feshie/ms2/README.md

# ms2
second version of the feshie node with the z1 replaced with a plug-in arm processor (TI CC2538)
