feshie/ms2/Muntjac/Partlist.txt

U1		http://onecall.farnell.com/texas-instruments/cc2538sf53rtqt/rf-zigbee-transceiver-qfn-56/dp/2422917
U2		CC1200: http://onecall.farnell.com/texas-instruments/cc1200rhbt/ic-low-power-rf-transceiver-32vqfn/dp/2345430
		CC1120: http://onecall.farnell.com/texas-instruments/cc1120rhbt/rf-transceiver-vqfn-32/dp/2422922

U3		http://onecall.farnell.com/texas-instruments/tpd2e001drlr/esd-protection-array-2ch-sot-5/dp/2335444
U4		http://onecall.farnell.com/silicon-labs/cp2103-gm/usb-uart-bridge-smd-qfn-28-2103/dp/1291538
U5		http://onecall.farnell.com/nxp/bss138ps/mosfet-nn-ch-60v-0-32a-sot363/dp/1972664
U6		http://onecall.farnell.com/nxp/bss138ps/mosfet-nn-ch-60v-0-32a-sot363/dp/1972664
U7		http://onecall.farnell.com/nxp/bss138ps/mosfet-nn-ch-60v-0-32a-sot363/dp/1972664
U8		http://onecall.farnell.com/micron/m25p16-vmn6p/memory-flash-serial-16mbit-8nsoic/dp/1734973
U9		http://onecall.farnell.com/diodes-inc/dmg6602svt/mosfet-np-ch-30v-3-4-atsot23/dp/2061522
U10		http://onecall.farnell.com/diodes-inc/dmg6602svt/mosfet-np-ch-30v-3-4-atsot23/dp/2061522
U11		http://onecall.farnell.com/texas-instruments/sn74avc4t774pw/logic-74avc-transceiver-tssop16/dp/1630205
U12		http://onecall.farnell.com/texas-instruments/tmp102aidrlt/ic-temperature-sensor/dp/1652477

D1		http://onecall.farnell.com/nxp/bat754s/diode-schottky-dual/dp/SC11302

L2		http://onecall.farnell.com/murata/blm18pg600sn1d/ferrite-bead-0-1ohm-500ma-0603/dp/1515746
L3		http://onecall.farnell.com/murata/blm18pg600sn1d/ferrite-bead-0-1ohm-500ma-0603/dp/1515746

X1		CC1200:	http://onecall.farnell.com/epson/q22fa1280010112/crystal-40mhz-10pf-2mm-x-1-6mm/dp/2506959
		CC1120:	http://onecall.farnell.com/epson/q22fa1280011912/crystal-32mhz-10pf-2mm-x-1-6mm/dp/2506957

X2		http://onecall.farnell.com/abracon/abm8g-32-000mhz-b4y-t/crystal-32mhz-10pf-3-2-x-2-5mm/dp/2467852
X3		http://onecall.farnell.com/abracon/abs07-32-768khz-t/crystal-32-768khz-12-5pf-smd/dp/2101347

F1		http://onecall.farnell.com/johanson-technology/0900pc15j0013e/balun-imp-matched-868-928mhz-chip/dp/2341894
F2		http://onecall.farnell.com/johanson-technology/2450bm15a0015e/balun-imp-matched-2-4-2-5ghz-50ohm/dp/2341895		

H4		http://onecall.farnell.com/samtec/fts-105-01-l-d/header-1-27mm-thru-hole-10way/dp/1667728

SD1		http://onecall.farnell.com/molex/503182-1853/connector-micro-sd-push-push-1/dp/2334075

ANT		http://onecall.farnell.com/hirose-hrs/u-fl-r-smt-1-10/rf-coaxial-u-fl-straight-jack/dp/1688077

RST		http://onecall.farnell.com/c-k-components/kmr241g-lfs/switch-smd-4n-0-05a-32vdc-spst/dp/1437637
USR		http://onecall.farnell.com/c-k-components/kmr241g-lfs/switch-smd-4n-0-05a-32vdc-spst/dp/1437637

LED		http://onecall.farnell.com/cree/clv1a-fkb-cj1m1f1bb7r4s3/led-red-grn-blu-550-850-320-mcd/dp/1855553
