feshie/ms2/Muntjac/MS2-BOM-Vals.xlsx

Main Section |  |  | 53
Qty/Brd | Tot | Value | Package | Parts
1 | 3 | USB | USB | J1
2 | 6 | Switch | C&K-KMR-5MM | RST, USR
1 | 3 | UFL | UFL | ANT
1 | 3 | BALUN-2.4G | 2450BM15A0015 | F2
1 | 3 | Tri-colour LED | PLCC-4_3.2X2.8 | LED
1 | 3 | LED Red | 0603 | LED1
1 | 3 | LED Yellow | 0603 | LED2
3 | 9 | 220 | 0603 | R20, R21, R22
2 | 6 | 1K5 | 0603 | R30, R31
3 | 9 | 4.7K | 0603 | R23, R24, R25
3 | 9 | 10k | 0603 | R9, R28, R29
1 | 3 | 56k | 0603 | R8
2 | 6 | 100K | 0603 | R18, R19
4 | 12 | 47p | 0603 | C7, C8, C12, C13
6 | 18 | 100nF | 0603 | C4, C16, C17, C18, C19, C23
7 | 21 | 1uF | 0603 | C2, C3, C9, C10 C14, C15, C22
1 | 3 | 4.7uF | 0603 | C1
1 | 3 | 32.768K | XTAL-3.2X1.5 | X3
1 | 3 | 32MHz | XTAL-3.2X2.5 | X2
3 | 9 | BEAD | 0603 | L2, L3, L5
1 | 3 | BAT54S | SOT23 | D1
1 | 3 | CC2538 | QFN 56 | U1
1 | 3 | TPD2E001IDRLRQ1 | SOT50 | U3
1 | 3 | CP2103 | QFN | U4
2 | 6 | BSS138PS | SOT65 | U5, U6
1 | 3 | M25P16VMN6P | SOIC8 | U8
1 | 3 | TMP102AIDRLT | SOT50 | U12
Through-hole |  |  | 3
Qty/Brd | Tot | Value | Package | Parts
2 | 6 | 2x8 Socket |  | Z1
1 | 3 | 2x11 Socket |  | Z1
Radio Parts |  |  | 33
Qty/Brd | Tot | Value | Package | Parts
1 | 3 | 0900PC15J0013 | Balun/Filter | F1
11 | 33 | 47nF | 0402 | C11, C51, C121, C131, C151, C221, C251, C261, C271, C281, C291
2 | 6 | 15pF | 0402 | C301, C311
1 | 3 | 100pF | 0402 | C172
1 | 3 | 10nH | 0402 | L171
1 | 3 | 220nF | 0402 | C61
1 | 3 | 1.8nF | 0402 | C231
2 | 6 | 10nF | 0402 | C171, C211
1 | 3 | 10R | 0402 | R171
1 | 3 | 33pF | 0402 | C173
1 | 3 | 56K | 0402 | R141
1 | 3 | Crystal | FA-128 | X1 (32MHz for CC1120, 40MHz for CC1200)
1 | 3 | CC1120 | QFN 32 | U2
2 | 6 | BEAD | 0603 | L1, L4
2 | 6 | 100nF | 0603 | C5, C6
2 | 6 | 100K | 0603 | R11, R13
1 | 3 | DMG6602SVT | TSOT26 | U9
1 | 3 | SMA | SMA | ANT_868
SD Card Parts |  |  | 8
Qty/Brd | Tot | Value | Package | Parts
1 | 3 | 1uF | 0603 | C20
1 | 3 | 22uF | 0603 | C21
1 | 3 | MICRO_SD | uSD | SD1
1 | 3 | SN74AVC4T774PW | SOP65 | U11
3 | 9 | 100K | 0603 | R10, R14, R15
1 | 3 | DMG6602SVT | TSOT26 | U10
