feshie/ms2/ms2/MS2-BOM-Vals.xlsx

Qty | Value | Device | Package | Parts | Description | MANUFACTURER | MPN | OC_ONECALL
2 | 10pF | C-EUC0805 | C0805 | C4, C14 | CAPACITOR, European symbol | Multicomp | MC0805N100J500CT | 2320834
2 | 100nF | C-EUC0805 | C0805 | C9, C11, C17, C19, C20, C21, C22, C23 | CAPACITOR, European symbol | Multicomp | MC0805B104K500CT | 1759265
2 | 0.22uF | C-EUC0805 | C0805 | C2, C13 | CAPACITOR, European symbol | Multicomp | MC0805F224Z500CT | 1759269
3 | 1uF | C-EUC0805 | C0805 | C8, C10, C16 | CAPACITOR, European symbol | Multicomp | MC0805X105K250CT | 2320832
1 | 10 | R-EU_R0805 | R0805 | R16 | RESISTOR, European symbol | Multicomp | MCWR08X10R0FTL | 2447556
8 | 68 | R-EU_R0805 | R0805 | R14, R15, R18, R19, R23, R24, R26, R31 | RESISTOR, European symbol | Multicomp | MCHP05W4F680JT5E | 1576443
14 | 100K | R-EU_R0805 | R0805 | R1, R5, R6, R7, R10, R11, R12, R13, R28, R29, R33, R35, R38, R39 | RESISTOR, European symbol | Multicomp | MCHP05W4F1003T5E | 1576493
6 | 1M | R-EU_R0805 | R0805 | R2, R4, R20, R34, R36, R37 | RESISTOR, European symbol | Multicomp | MCHP05W4F1004T5E | 1576507
4 | 2.2uF | C-EUC0805 | C0805 | C1, C6, C12, C18 | CAPACITOR, European symbol | Murata | GRM21BR61H225KA73L | 1845751RL
1 | 68uF | CPOL-EUE | PANASONIC_E | C15 | POLARIZED CAPACITOR, European symbol | Panasonic | EEEFC1E680P | 9693530
3 | 100uF | CPOL-EUE | PANASONIC_E | C5, C7, C24 | POLARIZED CAPACITOR, European symbol | Panasonic | EEEFK1E101P | 9695770
4 | 120 | R-EU_R0805 | R0805 | R22, R27, R30, R32 | RESISTOR, European symbol | Multicomp | MCHP05W4F1200T5E | 1576447RL
2 | 680 | R-EU_R0805 | R0805 | R17, R25 | RESISTOR, European symbol | Multicomp | MCHP05W4F6800T5E | 1576456
1 | 1K 0.1% | R-EU_R0805 | R0805 | R8 | RESISTOR, European symbol | Panasonic | ERA6AEB102V | 1577659
1 | 200R 0.1% | R-EU_R0805 | R0805 | R9 | RESISTOR, European symbol | Panasonic | ERA6AEB201V | 1670217
1 | 332K | R-EU_R0805 | R0805 | R21 | RESISTOR, European symbol | Welwyn | PCF0805R-332KBT1 | 1160284
1 | 562K | R-EU_R0805 | R0805 | R3 | RESISTOR, European symbol | Welwyn | PCF0805R-562KBT1 | 1160297
2 | BEAD | BEAD | 0805 | L3, L4 | INDUCTOR, European symbol | Murata | BLM21PG121SN1D | 2443252RL
1 | 47uH | SRU1048 | 1048 | L1 | CHOKE, POWER, SHIELDED, 47UH, 10mm x 10mm x 4.8mm | Bourns | SRU1048-470Y | 1362022
1 | 68uH | DR127 | DR127 | L5 | INDUCTOR, 68UH, POWER, SHIELDED, SMD | Bourns | SRR1260-680M | 2212503
1 | B130LB-13-F | DIODE-SMB | SMB | D1 | DIODE, REC, SCHOTTKY, 30V, 1A, SMB | Diodes Inc | B130LB-13-F | 1858651
5 | DMG6602SVT | DMG6602SVT | TSOT26 | Q1, Q2, Q3, Q4, Q5 | MOSFET, NP CH, , 30V, 3.4, ATSOT23 | Diodes Inc | DMG6602SVT | 2061522
1 | DS3231SN | DS3231SN | SOIC-16 | U3 | Extremely Accurate I2C-Integrated RTC/TCXO/Crystal | Maxim | DS3231SN | 1593292
3 | ISL3179EIBZ | ISL3179EIBZ | SOIC-8 | U4, U5, U6 | TRANCEIVER | Intersil | ISL3179EIBZ | 1439860
2 | LT1934ES6TRMPBF | LT1934ES6TRMPBF | TSOT-23-6 | U1, U2 | Micropower Step-Down Switching Regulators | Linear Technology | LT1934ES6#TRMPBF | 1663810
2 | MBR0530T1G | MBR0530T1G | SOD123 | D11, D12 | SCHOTTKY BARRIER RECTIFIER | ON Semiconductor | MBR0530T1G | 1431036
4 | MBR0540 | MBR0540T3G | SOD123 | D2, D3, D4, D5 | SCHOTTKY BARRIER RECTIFIER | ON Semiconductor | MBR0540T3G | 2101839
13 | MCF0805 | MCF0805 | 0805 | F1, F2, F3, F4, F5, F6, F7, F8, F9, F10, F11, F15, F16 |  | Bourns | MF-PSMF020X-2 | 1294874RL
6 | LED Green | LEDCHIP-LED0805 | CHIP-LED0805 | LED5, LED8, LED9, LED10, LED11, LED12 | LED | KINGBRIGHT | KPT-2012SGC | 2099239
1 | LED Red | LEDCHIP-LED0805 | CHIP-LED0805 | LED4 | LED | KINGBRIGHT | KPT-2012SURCK | 2099241
1 | LED Orange | LEDCHIP-LED0805 | CHIP-LED0805 | LED2 | LED | KINGBRIGHT | KPT-2012SECK | 2099237
2 | LED Yellow | LEDCHIP-LED0805 | CHIP-LED0805 | LED1, LED6 | LED | KINGBRIGHT | KPT-2012YC | 2099243
2 | LED Blue | LEDCHIP-LED0805 | CHIP-LED0805 | LED3, LED7 | LED | KINGBRIGHT | KPT-2012QBC-D | 2217980
1 | SN74HC21PW | SN74HC21PW | SOP65P640X120-14N | U11 | Triple 3 Input positive NAND gate | Texas Instruments | SN74HC21PW | 1741215
1 | TPD2E001IDRLRQ1 | TPD2E001IDRLRQ1 | SOT50P160X60-5N | U7 | LOW-CAPACITANCE 2-CHANNEL ±15-kV ESD-PROTECTION ARRAY | Texas Instruments | TPD2E001IDRLRQ1 | 2496524
1 | TPS79333DBVR | TPS79333DBVR | SOT-23 | U8 | LOW-DROPOUT LINEAR REGULATORS | Texas Instruments | TPS79333DBVR | 1470478
1 | REG113NA | REG113NA | SOT-23 | U9 | LOW-DROPOUT LINEAR REGULATORS | Texas Instruments | REG113NA | 2342575
1 | TXS0108E | TXS0108E | TSSOP20 | U10 | Texas Instruments TXS0108E | Texas Instruments | TXS0108E | 1702548
1 | BUTTON_CELL_NEW | BUTTON_CELL_NEW | CR2016 | U$3 | CR2032 cell holder | Keystone | 3002 | 1650693
2 | CC1120-HEADER-SMT | CC1120-HEADER-SMT | CC1120-HEADERS-SMT | U$8 | 2x Harwin M50 | HARWIN | M50-3601042 | CN14037
