feshie/ms2/ms2/Powersupply.asc

C1: cap; 0.22µ; V=10 Irms=1.21 Rser=0.0269337 Lser=0 mfg="KEMET" pn="C0603C224K8RAC" type="X7R"
C2: polcap; 100µ; V=2 Irms=3 Rser=0.011 Lser=0 mfg="Rubycon" pn="2SXB100M" type="Al electrolytic"
C3: cap; 2.2µ
C4: cap; 10p; V=50 Irms=20.8m Rser=5.448 Lser=0
C6: polcap; 100µ; V=2 Irms=3 Rser=0.011 Lser=0 mfg="Rubycon" pn="2SXB100M" type="Al electrolytic"
D1: schottky; MBRS130L
D2: schottky; BAT54
D3: schottky; MBR0530L
L1: ind; 47µ; Ipk=0.2 Rser=2.145 Rpar=22000 Cpar=2p mfg="Wurth Elektronik" pn="744029470 WE-TPC 2813"
R1: RES; 1Meg; tol=1 pwr=0.1
R2: res; 569K
R3: RES; 1000K
R4: RES; 100K
R5: res; 220; tol=1 pwr=1
R6: res; 1Meg; tol=1 pwr=0.1
U1: LT1934
U3: LTC1844-3.3
V1: VOLTAGE; 12
Named nets: 0, OUT, IN, VIN, 3V4
.tran 50 startup
.options gmin=1e-10
