feshie/ms2/ms2/ms2.brd

## EAGLE design ms2/ms2.brd (2016-06-14)

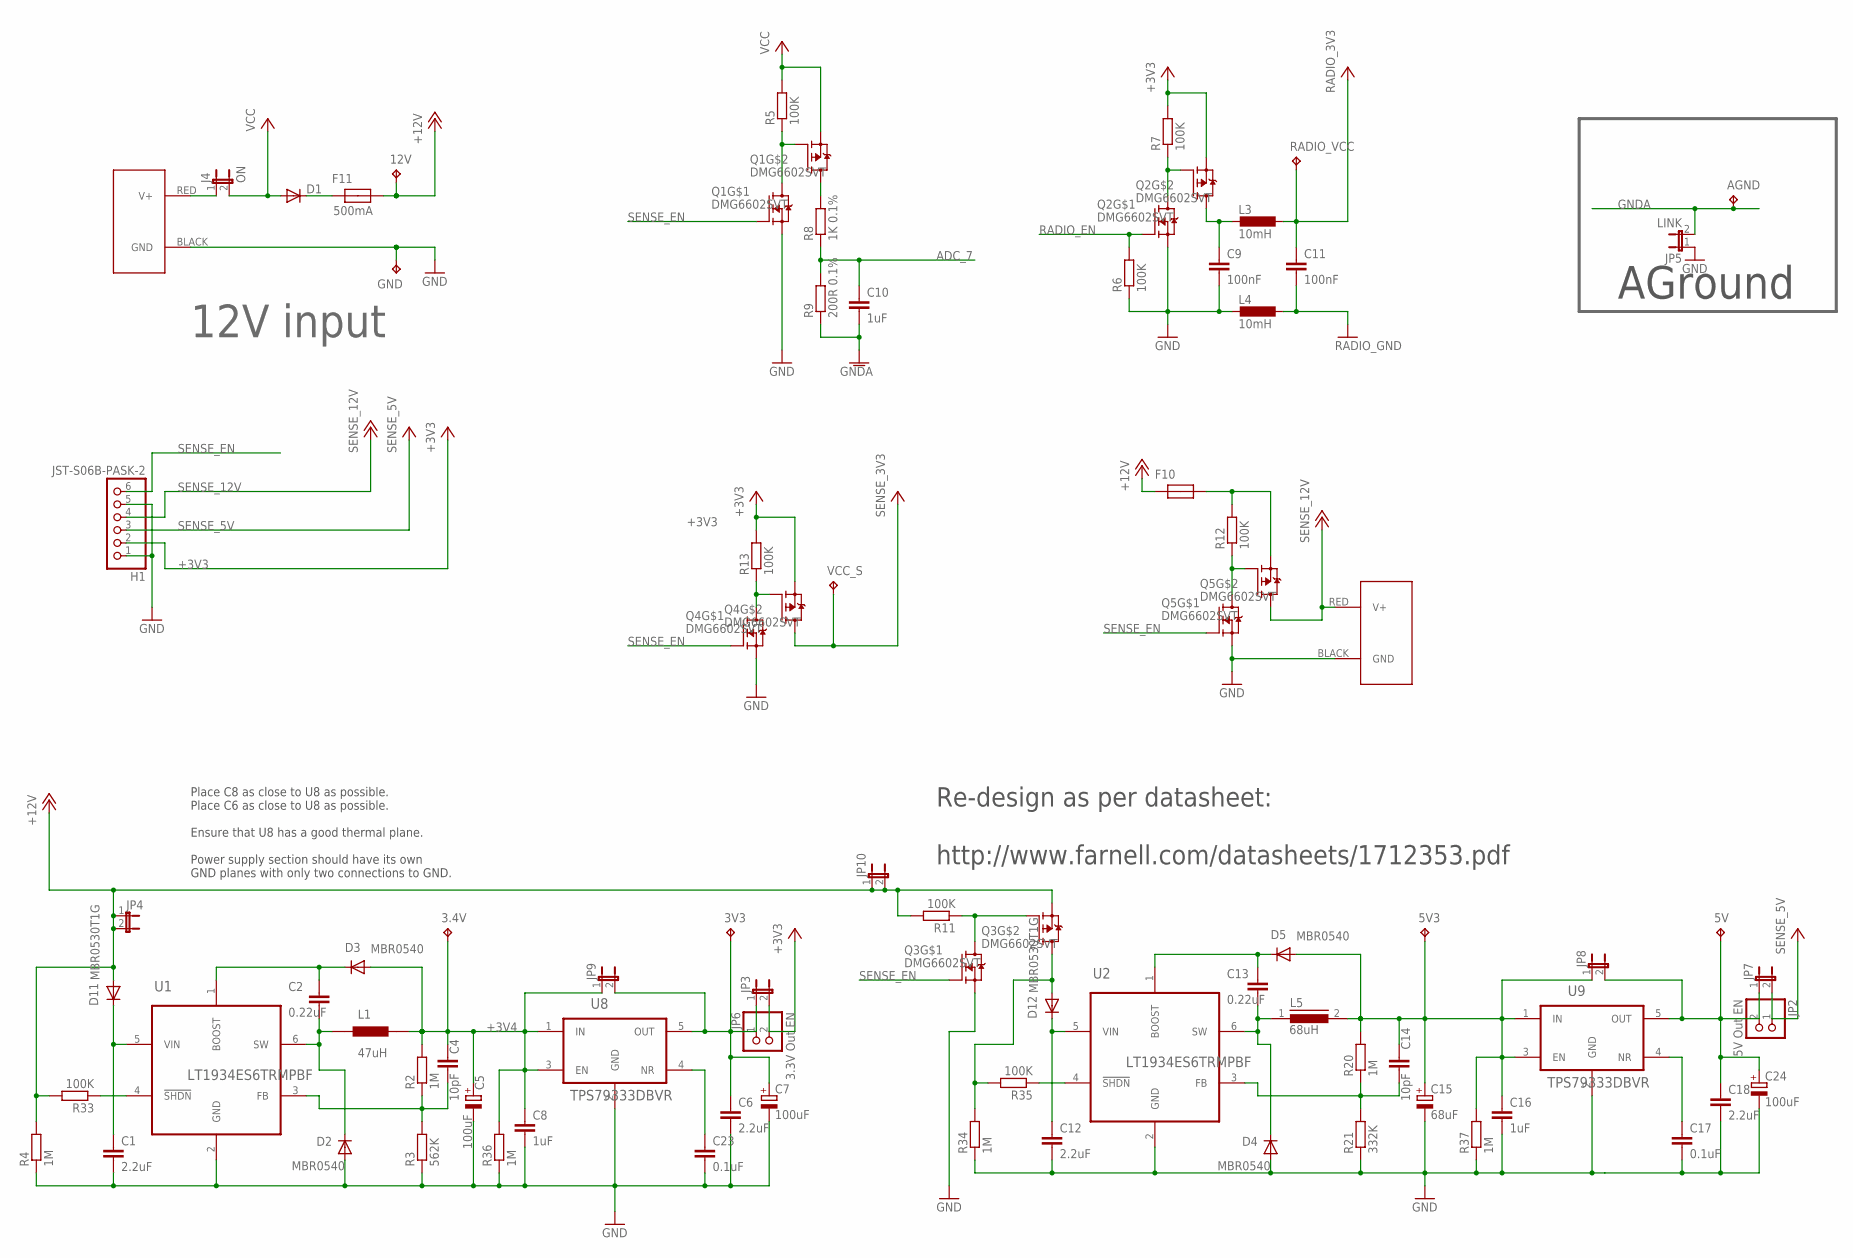
[picture p1: schematic ms2.sch, sheet 1, Power]

Parts:
3.4V, 3V3, 12V: TPB2,54; B2,54
5V, 5V3: 5V B; B2,54
12V_OUT: POWERPOLE_POWER45A; POWERPOLE_PAIR_45A
AGND: TPB2,54; B2,54
C1, C6, C12, C18: 2.2uF; C0805
C2, C13: 0.22uF; C0805
C4, C14: 10pF; C0805
C5, C7, C24: 100uF; PANASONIC_E
C8, C10, C16: 1uF; C0805
C9, C11: 100nF; C0805
C15: 68uF; PANASONIC_E
C17, C23: 0.1uF; C0805
D1: DIODE-SMB; SMB
D2, D3, D4, D5: MBR0540; SOD123
D11, D12: MBR0530T1G; SOD123
F10, F11: MCF0805; 0805
GND: 5V B; B2,54
H1: JST-S06B-PASK-2; JST-PA-6-SE
J1: POWERPOLE_POWER45A; POWERPOLE_PAIR_45A
J4: ON; 2-MOLEX
JP2: 5V Out EN; 1X02
JP3, JP4, JP7, JP8, JP9, JP10: JUMPER-2SMD-NO; SJ_2S-NO
JP5: LINK; JP1
JP6: 3.3V Out EN; 1X02
L1: 47uH; 1048
L3, L4: 10mH; L3230M
L5: 68uH; DR127
Q1, Q2, Q3, Q4, Q5: DMG6602SVT; TSOT26
R2, R4, R20, R34, R36, R37: 1M; R0805
R3: 562K; R0805
R5, R6, R7, R11, R12, R13, R33, R35: 100K; R0805
R8: 1K 0.1%; R0805
R9: 200R 0.1%; R0805
R21: 332K; R0805
RADIO_VCC: TPB2,54; B2,54
U1, U2: LT1934ES6TRMPBF; SOT95P280X100-6N
U8, U9: TPS79333DBVR; SOT95P280X145-5N
VCC_S: TPB2,54; B2,54

Connections:
5V3: 5V3.TP, C14.1, C15.+, C16.1, D5.A, JP8.1, L5.2, R20.2, R37.2, U9.1 (IN), U9.3 (EN)
+3V3: H1.2, JP3.2, JP6.2, Q2.P$2 (S), Q4.P$2 (S), R7.2, R13.2; also elsewhere on the board
+3V4: 3.4V.TP, C4.1, C5.+, C8.1, D3.A, JP9.1, L1.2, R2.2, R36.2, U8.1 (IN), U8.3 (EN)
+12V: 12V.TP, D11.A, F10.1, F11.2, JP4.1, JP4.2, JP10.1, JP10.2, Q3.P$2 (S), R4.2, R11.2, R33.2
ADC_7: C10.1, R8.1, R9.2; also elsewhere on the board
GND: 12V_OUT.BLACK (GND), C1.2, C5.-, C6.2, C7.-, C8.2, C9.2, C12.2, C15.-, C16.2, C17.2, C18.2, C23.2, C24.-, D2.A, D4.A, GND.TP, H1.1, H1.5, J1.BLACK (GND), JP5.1, L4.2, Q1.P$5 (S), Q2.P$5 (S), Q3.P$5 (S), Q4.P$5 (S), Q5.P$5 (S), R3.1, R4.1, R6.1, R21.1, R34.1, R36.1, R37.1, U1.2 (GND), U2.2 (GND), U8.2 (GND), U9.2 (GND); also elsewhere on the board
GNDA: AGND.TP, C10.2, JP5.2, R9.1; also elsewhere on the board
unnamed: J1.RED (V+), J4.1
unnamed: C13.1, D5.C, U2.1 (BOOST)
unnamed: D1.C, F11.1
unnamed: C23.1, U8.4 (NR)
unnamed: Q2.P$3 (G), Q2.P$6 (D), R7.1
unnamed: Q1.P$3 (G), Q1.P$6 (D), R5.1
unnamed: 5V.TP, C18.1, C24.+, JP2.2, JP7.1, JP8.2, U9.5 (OUT)
unnamed: C9.1, L3.2, Q2.P$4 (D)
unnamed: Q3.P$3 (G), Q3.P$6 (D), R11.1
unnamed: Q4.P$3 (G), Q4.P$6 (D), R13.1
unnamed: C12.1, D12.C, U2.5 (VIN)
unnamed: C13.2, D4.C, L5.1, U2.6 (SW)
unnamed: C4.2, R2.1, R3.2, U1.3 (FB)
unnamed: 3V3.TP, C6.1, C7.+, JP3.1, JP6.1, JP9.2, U8.5 (OUT)
unnamed: C14.2, R20.1, R21.2, U2.3 (FB)
unnamed: Q5.P$3 (G), Q5.P$6 (D), R12.1
unnamed: F10.2, Q5.P$2 (S), R12.2
unnamed: C1.1, D11.C, U1.5 (VIN)
unnamed: R33.1, U1.4 (!SHDN)
unnamed: R35.1, U2.4 (!SHDN)
unnamed: D12.A, Q3.P$4 (D), R34.2, R35.2
unnamed: C17.1, U9.4 (NR)
unnamed: C2.2, D2.C, L1.1, U1.6 (SW)
unnamed: C2.1, D3.C, U1.1 (BOOST)
RADIO_3V3: C11.1, L3.1, RADIO_VCC.TP; also elsewhere on the board
RADIO_EN: Q2.P$1 (G), R6.2; also elsewhere on the board
RADIO_GND: C11.2, L4.1; also elsewhere on the board
SENSE_3V3: Q4.P$4 (D), VCC_S.TP; also elsewhere on the board
SENSE_5V: H1.3, JP2.1, JP7.2; also elsewhere on the board
SENSE_12V: 12V_OUT.RED (V+), H1.4, Q5.P$4 (D); also elsewhere on the board
SENSE_EN: H1.6, Q1.P$1 (G), Q3.P$1 (G), Q4.P$1 (G), Q5.P$1 (G); also elsewhere on the board
VCC: D1.A, J4.2, Q1.P$2 (S), R5.2; also elsewhere on the board
VCC_HP2_SW1: Q1.P$4 (D), R8.2

Notes on the sheet:
12V input
AGround
Re-design as per datasheet: http://www.farnell.com/datasheets/1712353.pdf
Place C8 as close to U8 as possible. Place C6 as close to U8 as possible. Ensure that U8 has a good thermal plane. Power supply section should have its own GND planes with only two connections to GND.
500mA

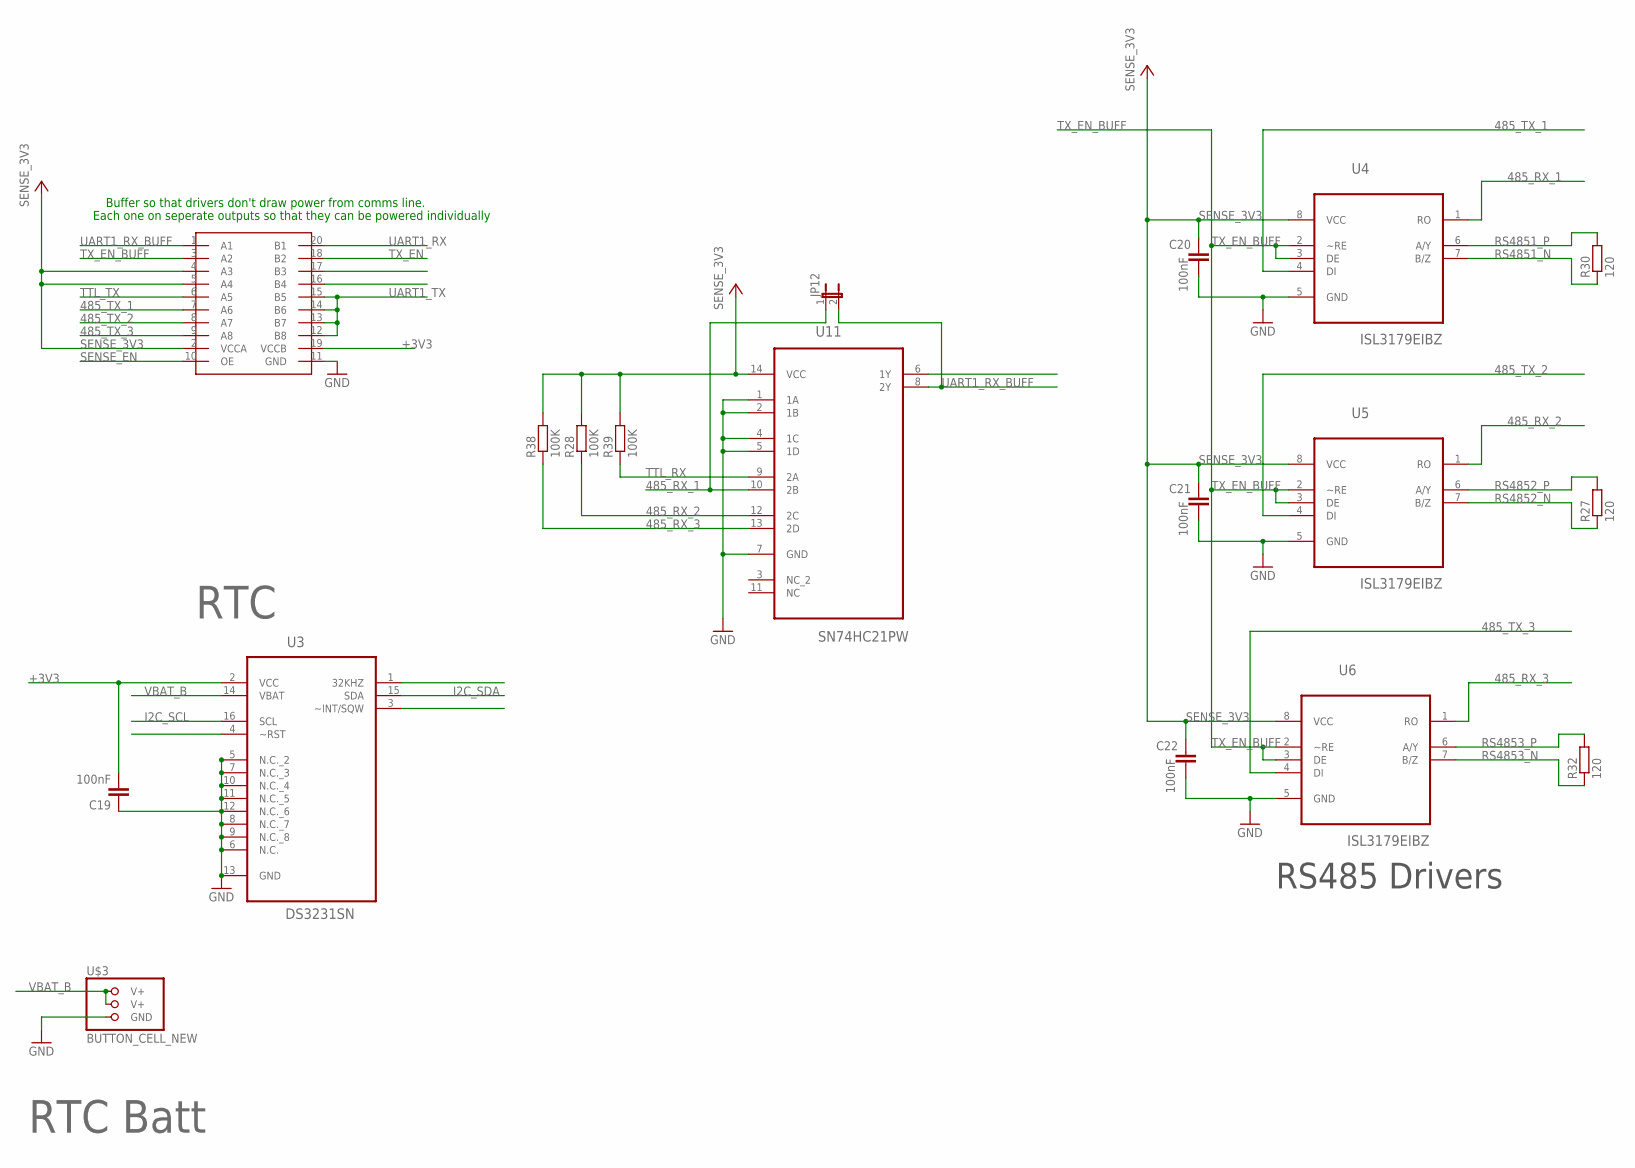
[picture p2: schematic ms2.sch, sheet 2, ICs]

Parts:
C19, C20, C21, C22: 100nF; C0805
JP12: JUMPER-2SMD-NO; SJ_2S-NO
R27, R30, R32: 120; R0805
R28, R38, R39: 100K; R0805
U3: DS3231SN; SOIC127P1032X265-16N
U4, U5, U6: ISL3179EIBZ; SOIC127P600X175-8N
U10: TXS0108E; TSSOP20
U11: SN74HC21PW; SOP65P640X120-14N
U$3: BUTTON_CELL_NEW; CR2016

Connections:
485_RX_1: JP12.1, U4.1 (RO), U11.10 (2B)
485_RX_2: R28.1, U5.1 (RO), U11.12 (2C)
485_RX_3: R38.1, U6.1 (RO), U11.13 (2D)
485_TX_1: U4.4 (DI), U10.7 (A6)
485_TX_2: U5.4 (DI), U10.8 (A7)
485_TX_3: U6.4 (DI), U10.9 (A8)
+3V3: C19.2, U3.2 (VCC), U10.19 (VCCB); also elsewhere on the board
GND: C19.1, C20.2, C21.2, C22.2, U3.5 (N.C._2), U3.6 (N.C.), U3.7 (N.C._3), U3.8 (N.C._7), U3.9 (N.C._8), U3.10 (N.C._4), U3.11 (N.C._5), U3.12 (N.C._6), U3.13 (GND), U4.5 (GND), U5.5 (GND), U6.5 (GND), U10.11 (GND), U11.1 (1A), U11.2 (1B), U11.4 (1C), U11.5 (1D), U11.7 (GND), U$3.GND; also elsewhere on the board
I2C_SCL: U3.16 (SCL); also elsewhere on the board
I2C_SDA: U3.15 (SDA); also elsewhere on the board
RS4851_N: R30.1, U4.7 (B/Z); also elsewhere on the board
RS4851_P: R30.2, U4.6 (A/Y); also elsewhere on the board
RS4852_N: R27.1, U5.7 (B/Z); also elsewhere on the board
RS4852_P: R27.2, U5.6 (A/Y); also elsewhere on the board
RS4853_N: R32.1, U6.7 (B/Z); also elsewhere on the board
RS4853_P: R32.2, U6.6 (A/Y); also elsewhere on the board
SENSE_3V3: C20.1, C21.1, C22.1, R28.2, R38.2, R39.2, U4.8 (VCC), U5.8 (VCC), U6.8 (VCC), U10.2 (VCCA), U10.4 (A3), U10.5 (A4), U11.14 (VCC); also elsewhere on the board
SENSE_EN: U10.10 (OE); also elsewhere on the board
TTL_RX: R39.1, U11.9 (2A); also elsewhere on the board
TTL_TX: U10.6 (A5); also elsewhere on the board
TX_EN: U10.18 (B2); also elsewhere on the board
TX_EN_BUFF: U4.2 (~RE), U4.3 (DE), U5.2 (~RE), U5.3 (DE), U6.2 (~RE), U6.3 (DE), U10.3 (A2)
UART1_RX: U10.20 (B1); also elsewhere on the board
UART1_RX_BUFF: JP12.2, U10.1 (A1), U11.8 (2Y)
UART1_TX: U10.12 (B8), U10.13 (B7), U10.14 (B6), U10.15 (B5); also elsewhere on the board
VBAT_B: U3.14 (VBAT), U$3.V+@1 (V+), U$3.V+@2 (V+)

Notes on the sheet:
RTC
RS485 Drivers
Buffer so that drivers don't draw power from comms line.
Each one on seperate outputs so that they can be powered individually
RTC Batt

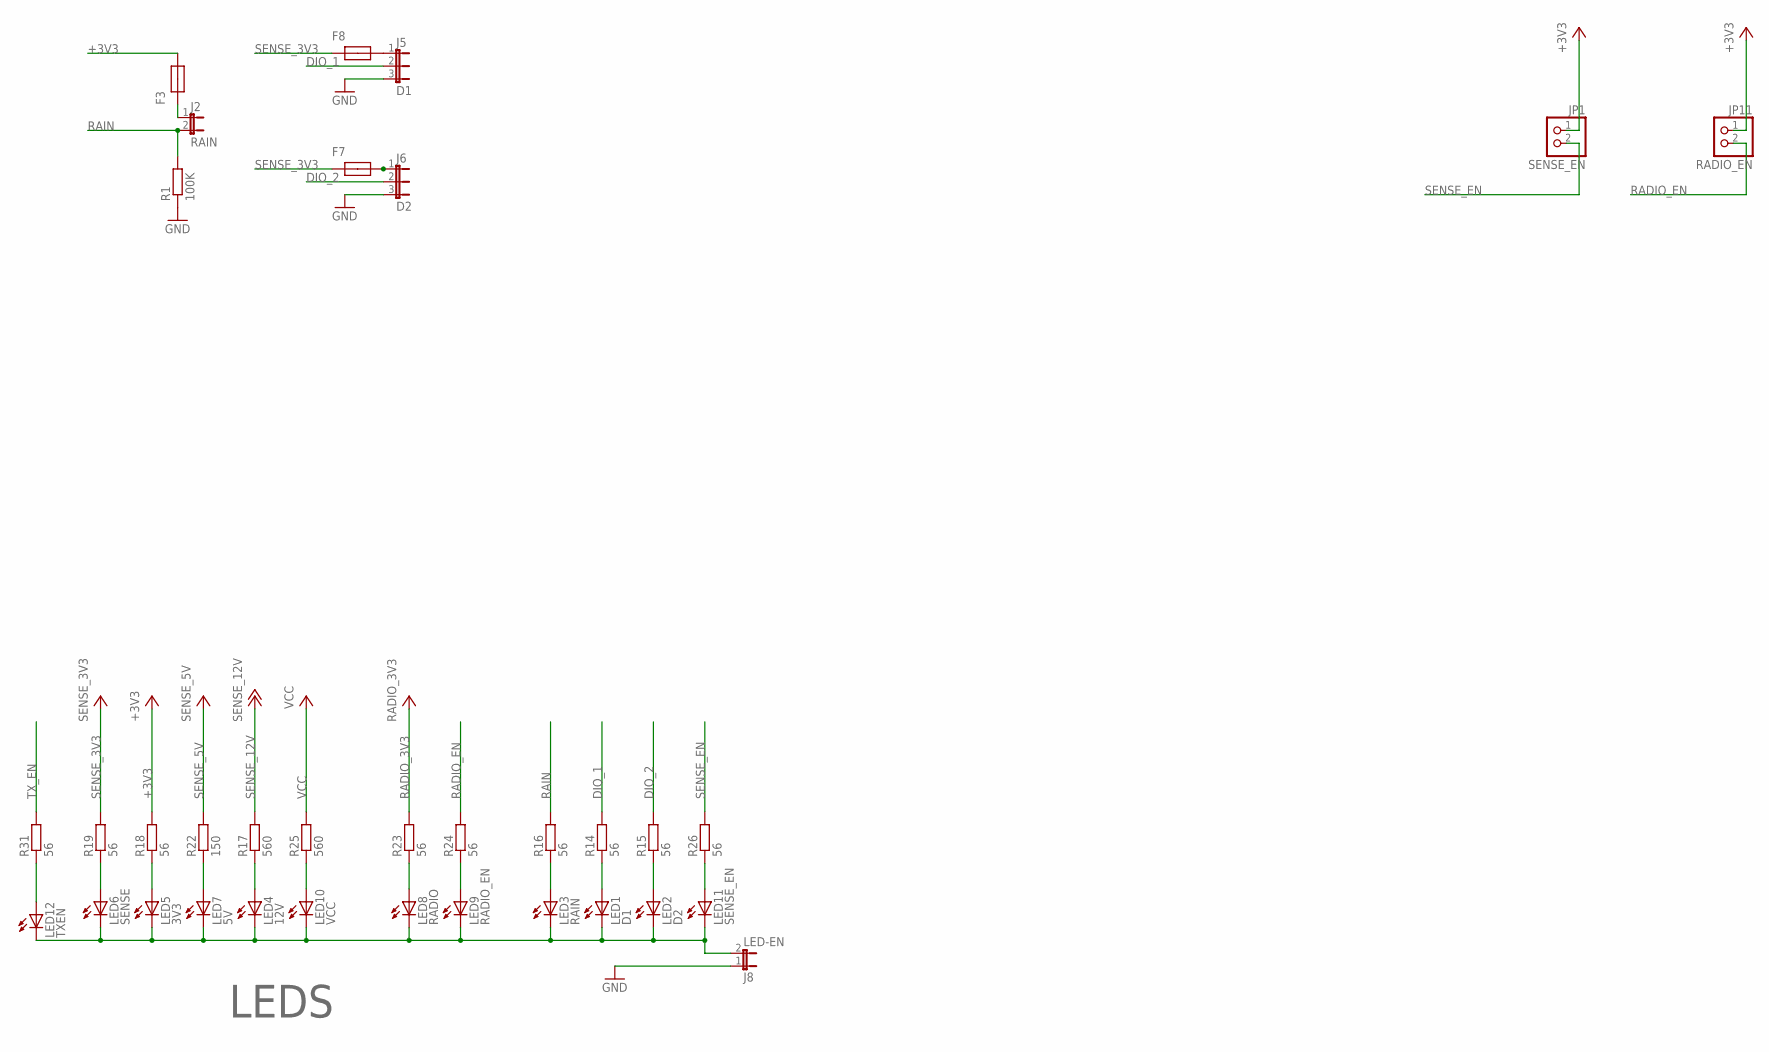
[picture p3: schematic ms2.sch, sheet 3, HMI]

Parts:
F3, F7, F8: MCF0805; 0805
J2: RAIN; 2-MOLEX
J5: D1; 3-MOLEX
J6: D2; 3-MOLEX
J8: LED-EN; 2-MOLEX
JP1: SENSE_EN; 1X02
JP11: RADIO_EN; 1X02
LED1: D1; CHIP-LED0805
LED2: D2; CHIP-LED0805
LED3: RAIN; CHIP-LED0805
LED4: 12V; CHIP-LED0805
LED5: 3V3; CHIP-LED0805
LED6: SENSE; CHIP-LED0805
LED7: 5V; CHIP-LED0805
LED8: RADIO; CHIP-LED0805
LED9: RADIO_EN; CHIP-LED0805
LED10: VCC; CHIP-LED0805
LED11: SENSE_EN; CHIP-LED0805
LED12: TXEN; CHIP-LED0805
R1: 100K; R0805
R14, R15, R16, R18, R19, R23, R24, R26, R31: 56; R0805
R17, R25: 560; R0805
R22: 150; R0805

Connections:
+3V3: F3.2, JP1.1, JP11.1, R18.2; also elsewhere on the board
DIO_1: J5.2, R14.2; also elsewhere on the board
DIO_2: J6.2, R15.2; also elsewhere on the board
GND: J5.3, J6.3, J8.1, R1.1; also elsewhere on the board
LGND: J8.2, LED1.C, LED2.C, LED3.C, LED4.C, LED5.C, LED6.C, LED7.C, LED8.C, LED9.C, LED10.C, LED11.C, LED12.C
unnamed: LED4.A, R17.1
unnamed: LED9.A, R24.1
unnamed: LED3.A, R16.1
unnamed: LED2.A, R15.1
unnamed: F7.2, J6.1
unnamed: F8.2, J5.1
unnamed: LED1.A, R14.1
unnamed: F3.1, J2.1
unnamed: LED12.A, R31.1
unnamed: LED11.A, R26.1
unnamed: LED10.A, R25.1
unnamed: LED8.A, R23.1
unnamed: LED7.A, R22.1
unnamed: LED6.A, R19.1
unnamed: LED5.A, R18.1
RADIO_3V3: R23.2; also elsewhere on the board
RADIO_EN: JP11.2, R24.2; also elsewhere on the board
RAIN: J2.2, R1.2, R16.2; also elsewhere on the board
SENSE_3V3: F7.1, F8.1, R19.2; also elsewhere on the board
SENSE_5V: R22.2; also elsewhere on the board
SENSE_12V: R17.2; also elsewhere on the board
SENSE_EN: JP1.2, R26.2; also elsewhere on the board
TX_EN: R31.2; also elsewhere on the board
VCC: R25.2; also elsewhere on the board

Notes on the sheet:
LEDS

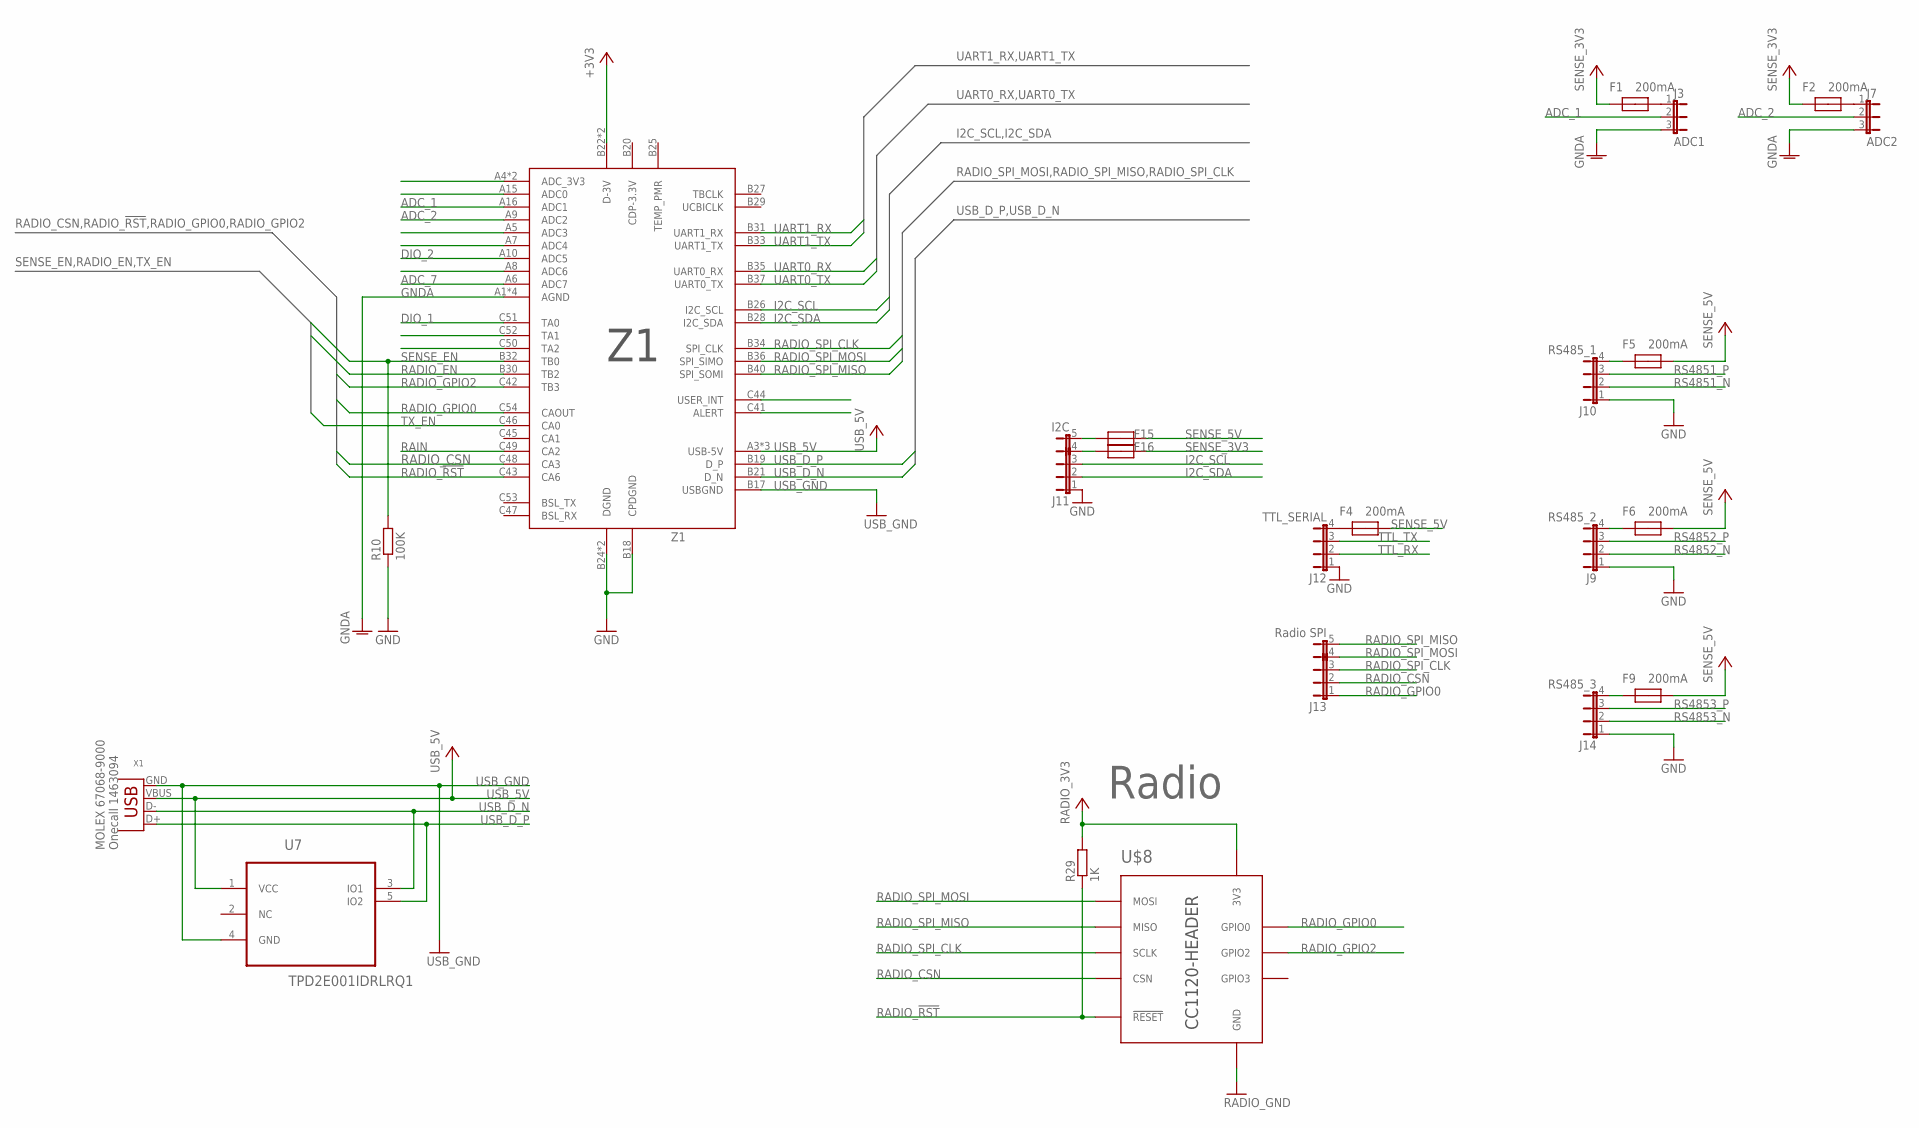
[picture p4: schematic ms2.sch, sheet 4, Headers]

Parts:
F1, F2, F4, F5, F6, F9, F15, F16: MCF0805; 0805
J3: ADC1; 3-MOLEX
J7: ADC2; 3-MOLEX
J9: RS485_2; 4-MOLEX
J10: RS485_1; 4-MOLEX
J11: I2C; 5-MOLEX
J12: TTL_SERIAL; 4-MOLEX
J13: Radio SPI; 5-MOLEX
J14: RS485_3; 4-MOLEX
R10: 100K; R0805
R29: 1K; R0805
U7: TPD2E001IDRLRQ1; SOT50P160X60-5N
U$8: CC1120-HEADER-SMT; CC1120-HEADERS-SMT
X1: 67068-9000; USB-B-H
Z1: Z1

Connections:
+3V3: Z1.B22 (D-3V), Z1.C40 (D-3V); also elsewhere on the board
ADC_1: J3.2, Z1.A16 (ADC1)
ADC_2: J7.2, Z1.A9 (ADC2)
ADC_7: Z1.A6 (ADC7); also elsewhere on the board
DIO_1: Z1.C51 (TA0); also elsewhere on the board
DIO_2: Z1.A10 (ADC5); also elsewhere on the board
GND: J9.1, J10.1, J11.1, J12.1, J14.1, R10.1, Z1.B18 (CPDGND), Z1.B24 (DGND), Z1.C39 (DGND); also elsewhere on the board
GNDA: J3.3, J7.3, Z1.A1 (AGND), Z1.A2 (AGND), Z1.A11 (AGND), Z1.A12 (AGND); also elsewhere on the board
I2C_SCL: J11.3, Z1.B26 (I2C_SCL); also elsewhere on the board
I2C_SDA: J11.2, Z1.B28 (I2C_SDA); also elsewhere on the board
unnamed: F5.1, J10.4
unnamed: F6.1, J9.4
unnamed: F4.1, J12.4
unnamed: F9.1, J14.4
unnamed: F1.2, J3.1
unnamed: F2.2, J7.1
unnamed: Z1.A4 (ADC_3V3), Z1.A14 (ADC_3V3)
unnamed: F16.1, J11.4
unnamed: F15.1, J11.5 (6)
RADIO_3V3: R29.2, U$8.3V3-1 (3V3), U$8.3V3-2 (3V3); also elsewhere on the board
RADIO_!RST: R29.1, U$8.RESET (!RESET), Z1.C43 (CA6)
RADIO_CSN: J13.2, U$8.CSN, Z1.C48 (CA3)
RADIO_EN: Z1.B30 (TB2); also elsewhere on the board
RADIO_GND: U$8.GND, U$8.GND1 (GND), U$8.GND2 (GND); also elsewhere on the board
RADIO_GPIO0: J13.1, U$8.GPIO0, Z1.C54 (CAOUT)
RADIO_GPIO2: U$8.GPIO2, Z1.C42 (TB3)
RADIO_SPI_CLK: J13.3, U$8.SCLK, Z1.B34 (SPI_CLK)
RADIO_SPI_MISO: J13.5 (6), U$8.MISO, Z1.B40 (SPI_SOMI)
RADIO_SPI_MOSI: J13.4, U$8.MOSI, Z1.B36 (SPI_SIMO)
RAIN: Z1.C49 (CA2); also elsewhere on the board
RS4851_N: J10.2; also elsewhere on the board
RS4851_P: J10.3; also elsewhere on the board
RS4852_N: J9.2; also elsewhere on the board
RS4852_P: J9.3; also elsewhere on the board
RS4853_N: J14.2; also elsewhere on the board
RS4853_P: J14.3; also elsewhere on the board
SENSE_3V3: F1.1, F2.1, F16.2; also elsewhere on the board
SENSE_5V: F4.2, F5.2, F6.2, F9.2, F15.2; also elsewhere on the board
SENSE_EN: R10.2, Z1.B32 (TB0); also elsewhere on the board
TTL_RX: J12.2; also elsewhere on the board
TTL_TX: J12.3; also elsewhere on the board
TX_EN: Z1.C46 (CA0); also elsewhere on the board
UART0_RX: Z1.B35 (UART0_RX)
UART0_TX: Z1.B37 (UART0_TX)
UART1_RX: Z1.B31 (UART1_RX); also elsewhere on the board
UART1_TX: Z1.B33 (UART1_TX); also elsewhere on the board
USB_5V: U7.1 (VCC), X1.VBUS, Z1.A3 (USB-5V), Z1.A13 (USB-5V), Z1.B23 (USB-5V)
USB_D_N: U7.3 (IO1), X1.D-, Z1.B21 (D_N)
USB_D_P: U7.5 (IO2), X1.D+, Z1.B19 (D_P)
USB_GND: U7.4 (GND), X1.GND, Z1.B17 (USBGND)

Notes on the sheet:
Radio
200mA
MOLEX 67068-9000 Onecall 1463094

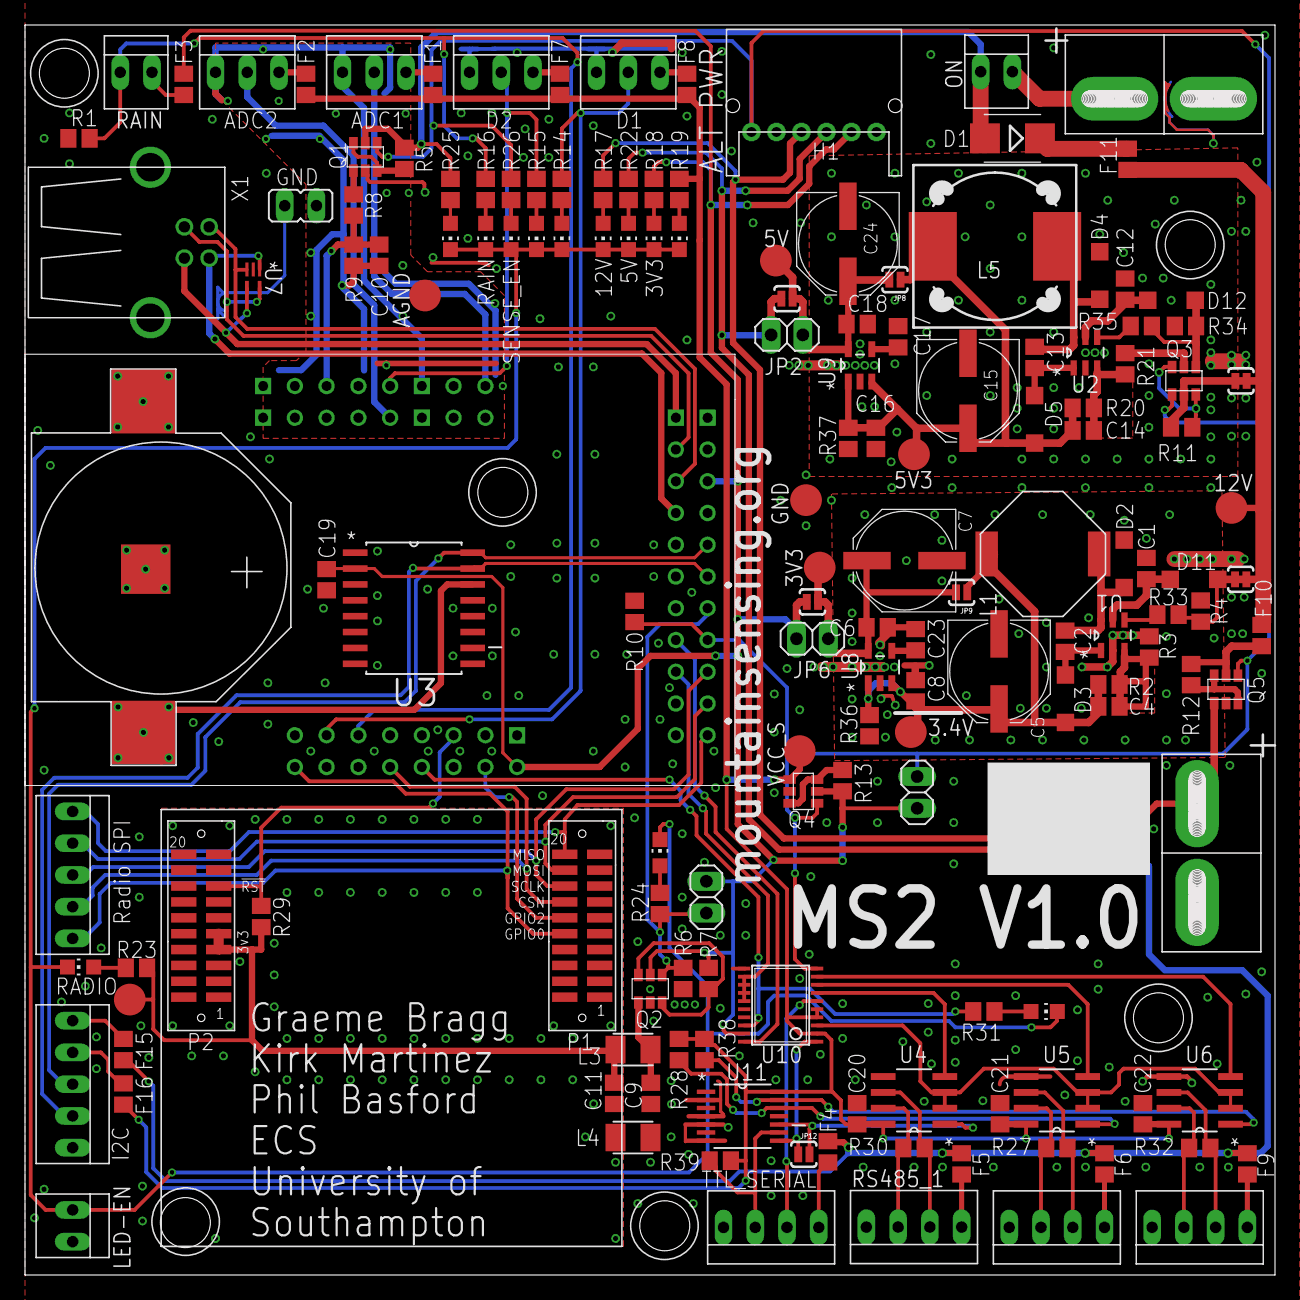
[picture p5: board ms2.brd from above]

Board: 2 copper layers, 100.0 x 100.0 mm, 155 parts (0 on the bottom side), 103 nets.
