feshie/ms2/cc1120/CC1200_Breakout.brd

## EAGLE design cc1120/CC1200_Breakout.brd (2016-06-06)

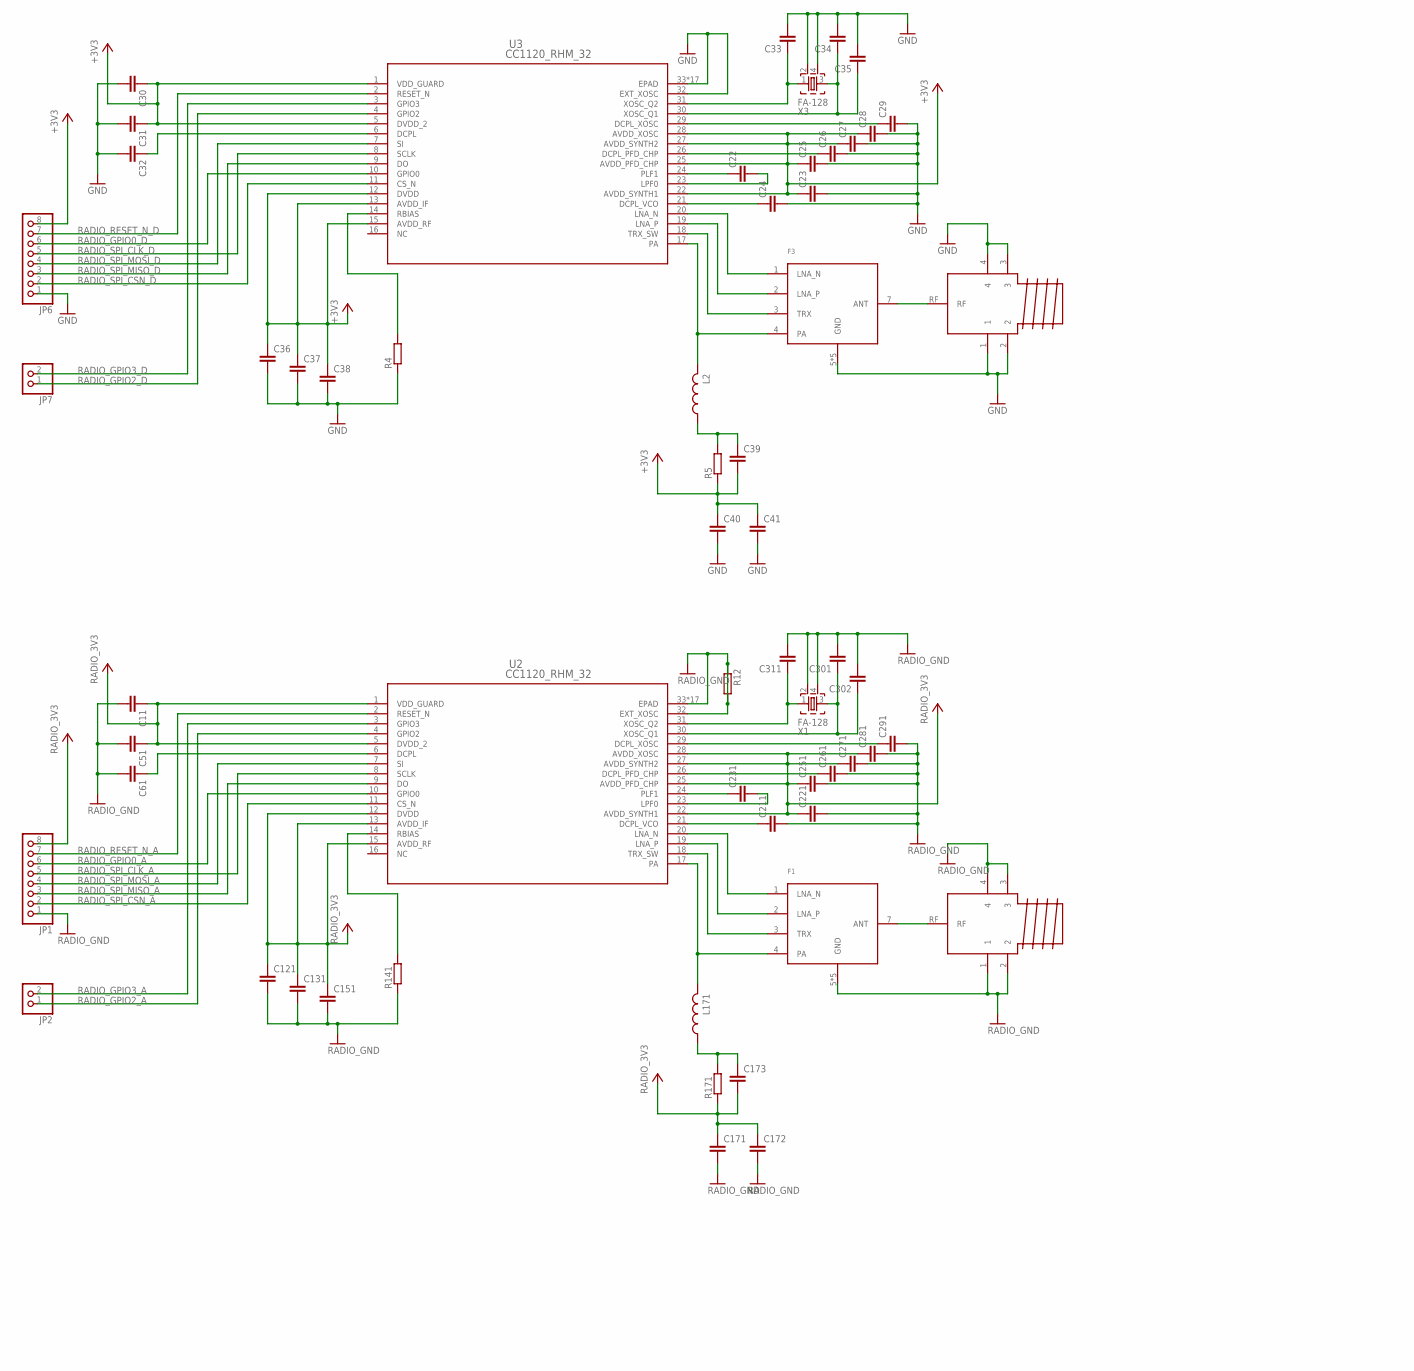
[picture p6: schematic CC1200_Breakout.sch, part in row 1, column 1]

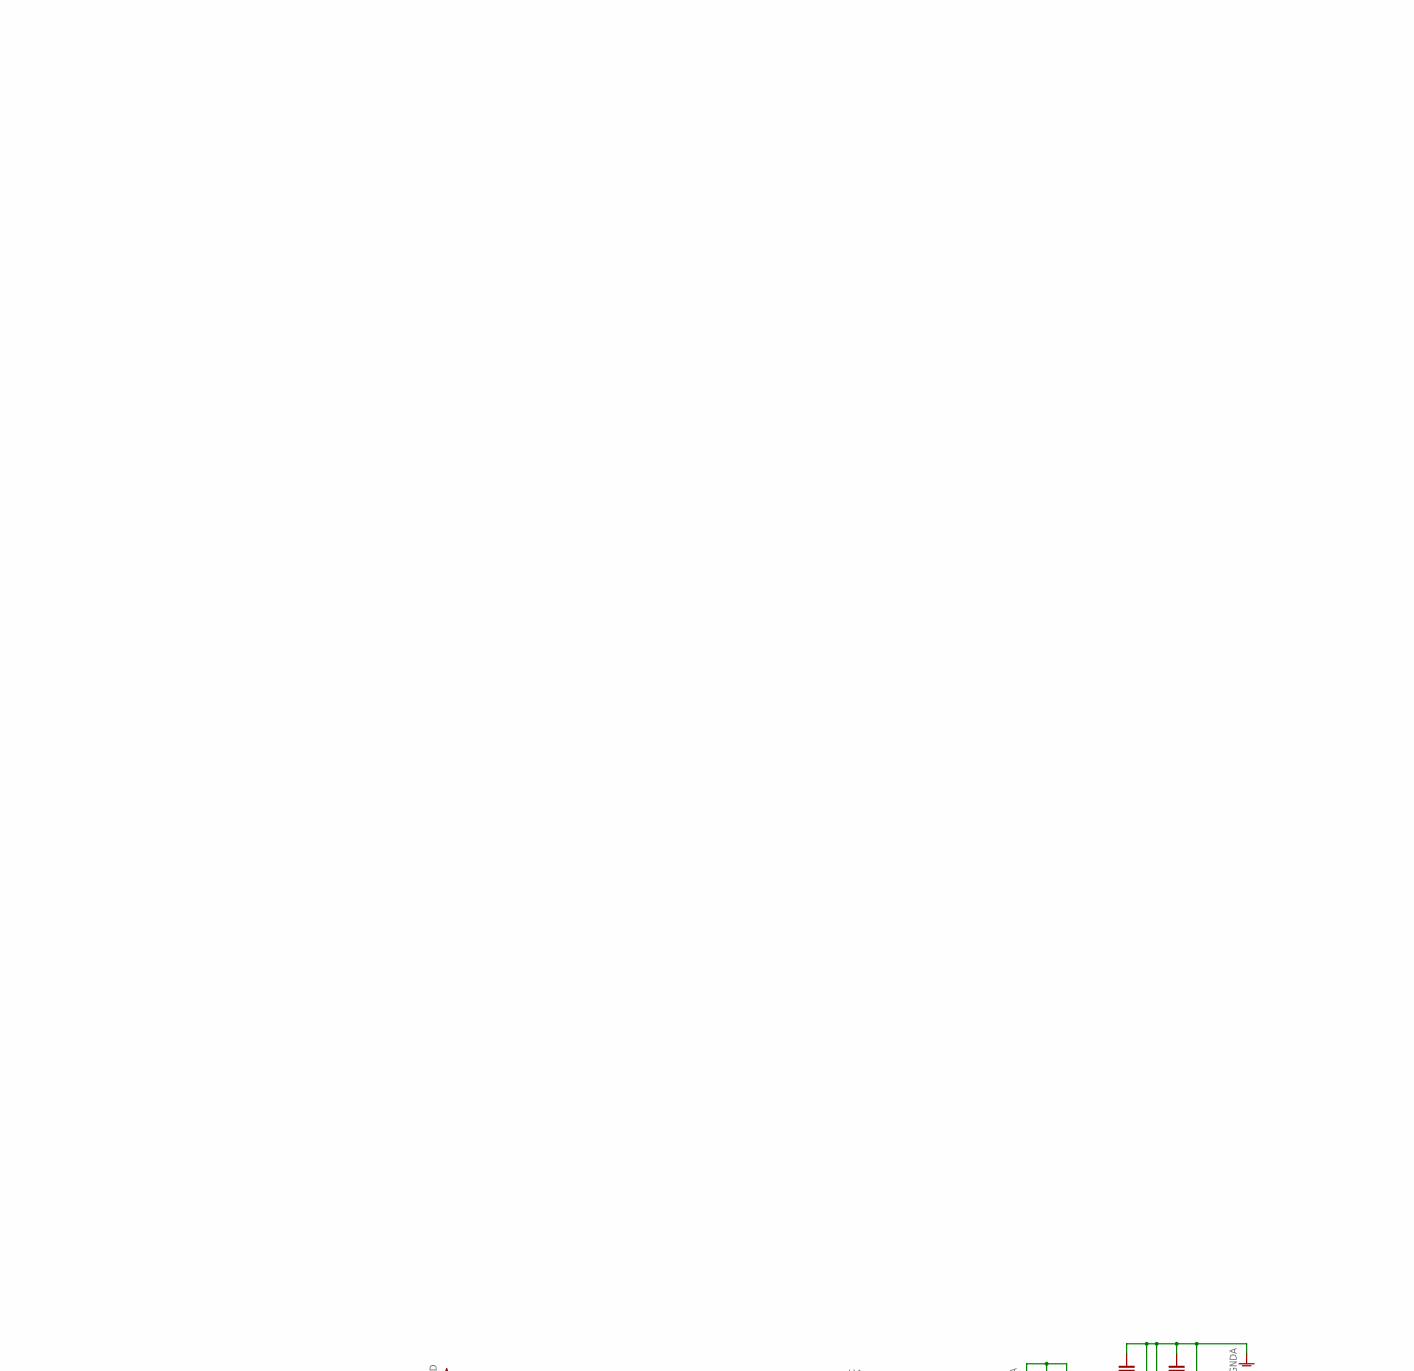
[picture p7: schematic CC1200_Breakout.sch, part in row 1, column 2]

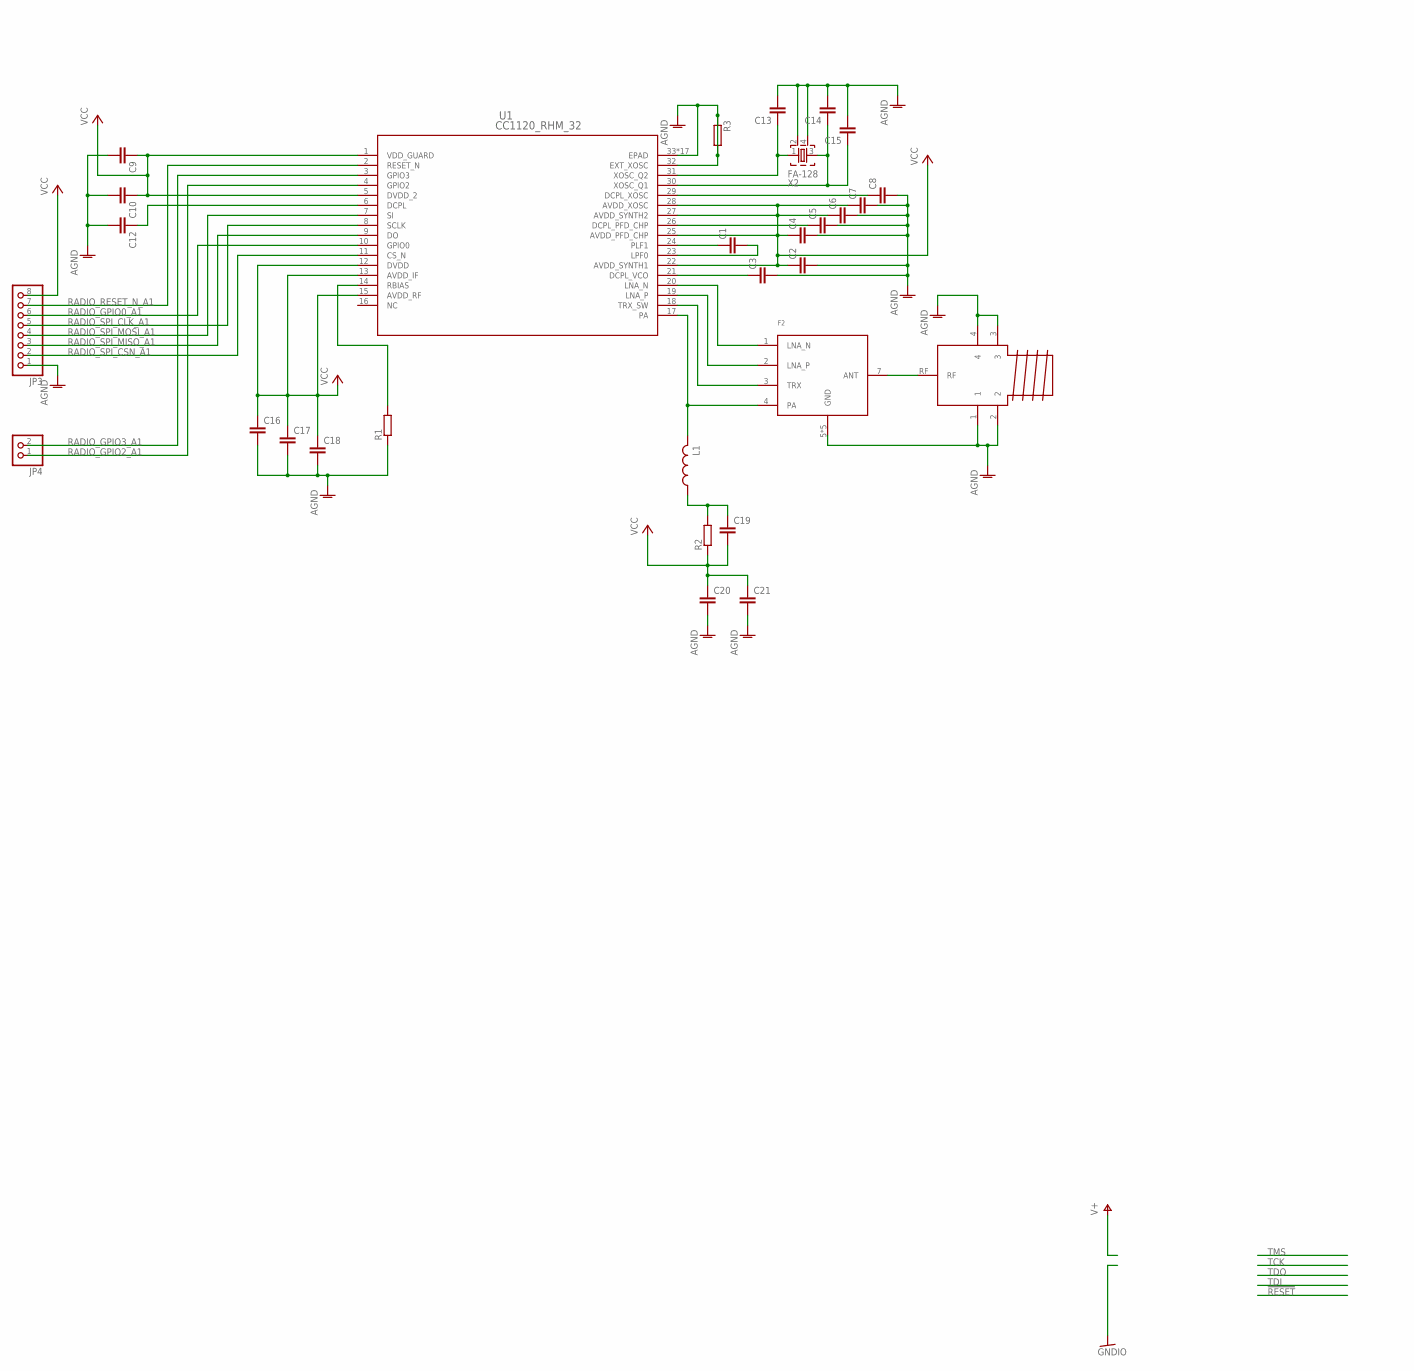
[picture p8: schematic CC1200_Breakout.sch, part in row 2, column 1]

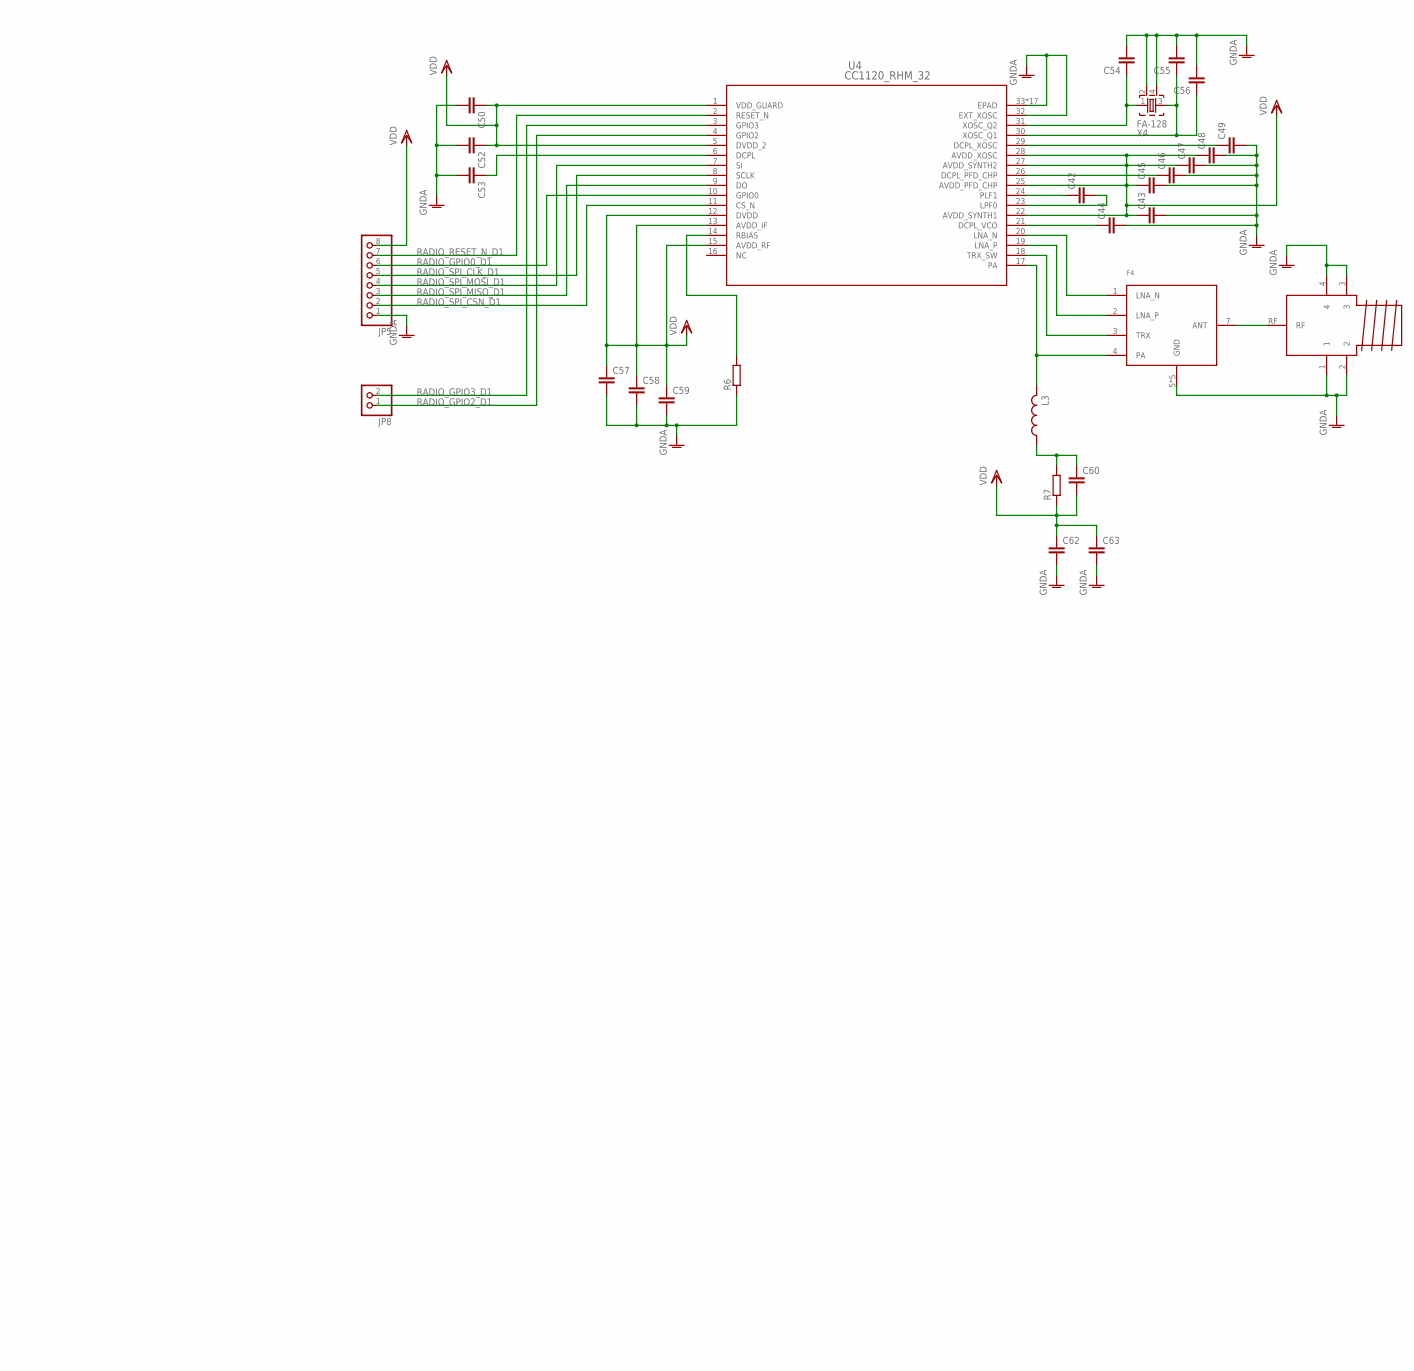
[picture p9: schematic CC1200_Breakout.sch, part in row 2, column 2]

Parts:
ANT_1, ANT_2, ANT_3, ANT_868: SMA; JOHNSON_142-0701-806
C1, C2, C3, C4, C5, C6, C7, C8, C9, C10, C11, C12, C13, C14, C15, C16, C17, C18, C19, C20, C21, C51, C61, C121, C131, C151, C171, C172, C173, C211, C221, C231, C251, C261, C271, C281, C291, C301, C302, C311: C_EU0402S; C0402_SMALL
C22, C23, C24, C25, C26, C27, C28, C29, C30, C31, C32, C33, C34, C35, C36, C37, C38, C39, C40, C41, C42, C43, C44, C45, C46, C47, C48, C49, C50, C52, C53, C54, C55, C56, C57, C58, C59, C60, C62, C63: C_EUC0603S; C0603
F1, F2, F3, F4: 0900PC15J0013
JP1, JP3, JP5, JP6: PINHD-1X8; 1X08
JP2, JP4, JP7, JP8: PINHD-1X2; 1X02
L1, L171: L_US0402S; C0402_SMALL
L2, L3: L_US0603; C0603
R1, R2, R3, R12, R141, R171: R_EU; C0402_SMALL
R4, R5, R6, R7: R-EU_R0603; R0603
U1, U2, U3, U4: CC1120_RHM_32; RHM32_3P7X3P7
X1, X2, X3, X4: FA-128

Connections:
+3V3: C23.1, C25.1, C27.1, C28.1, C30.1, C31.1, C36.1, C37.1, C38.1, C39.2, C40.1, C41.1, JP6.8, R5.1, U3.1 (VDD_GUARD), U3.5 (DVDD_2), U3.12 (DVDD), U3.13 (AVDD_IF), U3.15 (AVDD_RF), U3.22 (AVDD_SYNTH1), U3.25 (AVDD_PFD_CHP), U3.27 (AVDD_SYNTH2), U3.28 (AVDD_XOSC)
AGND: ANT_1.1, ANT_1.2, ANT_1.3, ANT_1.4, C2.2, C3.2, C4.2, C5.2, C6.2, C7.2, C8.2, C9.2, C10.2, C12.2, C13.2, C14.2, C15.2, C16.2, C17.2, C18.2, C20.2, C21.2, F2.5 (GND), F2.6 (GND), F2.8 (GND), F2.9 (GND), F2.10 (GND), JP3.1, R1.1, R3.1, R3.2, U1.32 (EXT_XOSC), U1.33 (EPAD), U1.V (EPAD), U1.V_2 (EPAD), U1.V_3 (EPAD), U1.V_4 (EPAD), U1.V_5 (EPAD), U1.V_6 (EPAD), U1.V_7 (EPAD), U1.V_8 (EPAD), U1.V_9 (EPAD), U1.V_10 (EPAD), U1.V_11 (EPAD), U1.V_12 (EPAD), U1.V_13 (EPAD), U1.V_14 (EPAD), U1.V_15 (EPAD), U1.V_16 (EPAD), X2.2, X2.4
GND: ANT_2.1, ANT_2.2, ANT_2.3, ANT_2.4, C23.2, C24.2, C25.2, C26.2, C27.2, C28.2, C29.2, C30.2, C31.2, C32.2, C33.2, C34.2, C35.2, C36.2, C37.2, C38.2, C40.2, C41.2, F3.5 (GND), F3.6 (GND), F3.8 (GND), F3.9 (GND), F3.10 (GND), JP6.1, R4.1, U3.32 (EXT_XOSC), U3.33 (EPAD), U3.V (EPAD), U3.V_2 (EPAD), U3.V_3 (EPAD), U3.V_4 (EPAD), U3.V_5 (EPAD), U3.V_6 (EPAD), U3.V_7 (EPAD), U3.V_8 (EPAD), U3.V_9 (EPAD), U3.V_10 (EPAD), U3.V_11 (EPAD), U3.V_12 (EPAD), U3.V_13 (EPAD), U3.V_14 (EPAD), U3.V_15 (EPAD), U3.V_16 (EPAD), X3.2, X3.4
GNDA: ANT_3.1, ANT_3.2, ANT_3.3, ANT_3.4, C43.2, C44.2, C45.2, C46.2, C47.2, C48.2, C49.2, C50.2, C52.2, C53.2, C54.2, C55.2, C56.2, C57.2, C58.2, C59.2, C62.2, C63.2, F4.5 (GND), F4.6 (GND), F4.8 (GND), F4.9 (GND), F4.10 (GND), JP5.1, R6.1, U4.32 (EXT_XOSC), U4.33 (EPAD), U4.V (EPAD), U4.V_2 (EPAD), U4.V_3 (EPAD), U4.V_4 (EPAD), U4.V_5 (EPAD), U4.V_6 (EPAD), U4.V_7 (EPAD), U4.V_8 (EPAD), U4.V_9 (EPAD), U4.V_10 (EPAD), U4.V_11 (EPAD), U4.V_12 (EPAD), U4.V_13 (EPAD), U4.V_14 (EPAD), U4.V_15 (EPAD), U4.V_16 (EPAD), X4.2, X4.4
unnamed: C231.1, U2.24 (PLF1)
unnamed: C231.2, U2.23 (LPF0)
unnamed: C211.1, U2.21 (DCPL_VCO)
unnamed: C61.1, U2.6 (DCPL)
unnamed: C261.1, U2.26 (DCPL_PFD_CHP)
unnamed: C311.1, U2.31 (XOSC_Q2), X1.1
unnamed: C301.1, C302.1, U2.30 (XOSC_Q1), X1.3
unnamed: C291.1, U2.29 (DCPL_XOSC)
unnamed: F1.1 (LNA_N), U2.20 (LNA_N)
unnamed: F1.2 (LNA_P), U2.19 (LNA_P)
unnamed: ANT_868.RF, F1.7 (ANT)
unnamed: F1.3 (TRX), U2.18 (TRX_SW)
unnamed: R141.2, U2.14 (RBIAS)
unnamed: F1.4 (PA), L171.2, U2.17 (PA)
unnamed: C1.1, U1.24 (PLF1)
unnamed: C1.2, U1.23 (LPF0)
unnamed: C3.1, U1.21 (DCPL_VCO)
unnamed: C5.1, U1.26 (DCPL_PFD_CHP)
unnamed: C173.1, L171.1, R171.2
unnamed: C8.1, U1.29 (DCPL_XOSC)
unnamed: C12.1, U1.6 (DCPL)
unnamed: C13.1, U1.31 (XOSC_Q2), X2.1
unnamed: C14.1, C15.1, U1.30 (XOSC_Q1), X2.3
unnamed: R1.2, U1.14 (RBIAS)
unnamed: F2.1 (LNA_N), U1.20 (LNA_N)
unnamed: F2.2 (LNA_P), U1.19 (LNA_P)
unnamed: F2.3 (TRX), U1.18 (TRX_SW)
unnamed: F2.4 (PA), L1.2, U1.17 (PA)
unnamed: C19.1, L1.1, R2.2
unnamed: ANT_1.RF, F2.7 (ANT)
unnamed: C22.1, U3.24 (PLF1)
unnamed: C22.2, U3.23 (LPF0)
unnamed: C24.1, U3.21 (DCPL_VCO)
unnamed: C26.1, U3.26 (DCPL_PFD_CHP)
unnamed: C29.1, U3.29 (DCPL_XOSC)
unnamed: C32.1, U3.6 (DCPL)
unnamed: C33.1, U3.31 (XOSC_Q2), X3.1
unnamed: C34.1, C35.1, U3.30 (XOSC_Q1), X3.3
unnamed: R4.2, U3.14 (RBIAS)
unnamed: F3.1 (LNA_N), U3.20 (LNA_N)
unnamed: F3.2 (LNA_P), U3.19 (LNA_P)
unnamed: F3.3 (TRX), U3.18 (TRX_SW)
unnamed: F3.4 (PA), L2.2, U3.17 (PA)
unnamed: C39.1, L2.1, R5.2
unnamed: ANT_2.RF, F3.7 (ANT)
unnamed: C42.1, U4.24 (PLF1)
unnamed: C42.2, U4.23 (LPF0)
unnamed: C44.1, U4.21 (DCPL_VCO)
unnamed: C46.1, U4.26 (DCPL_PFD_CHP)
unnamed: C49.1, U4.29 (DCPL_XOSC)
unnamed: C53.1, U4.6 (DCPL)
unnamed: C54.1, U4.31 (XOSC_Q2), X4.1
unnamed: C55.1, C56.1, U4.30 (XOSC_Q1), X4.3
unnamed: R6.2, U4.14 (RBIAS)
unnamed: F4.1 (LNA_N), U4.20 (LNA_N)
unnamed: F4.2 (LNA_P), U4.19 (LNA_P)
unnamed: F4.3 (TRX), U4.18 (TRX_SW)
unnamed: F4.4 (PA), L3.2, U4.17 (PA)
unnamed: C60.1, L3.1, R7.2
unnamed: ANT_3.RF, F4.7 (ANT)
RADIO_3V3: C11.1, C51.1, C121.1, C131.1, C151.1, C171.1, C172.1, C173.2, C221.1, C251.1, C271.1, C281.1, JP1.8, R171.1, U2.1 (VDD_GUARD), U2.5 (DVDD_2), U2.12 (DVDD), U2.13 (AVDD_IF), U2.15 (AVDD_RF), U2.22 (AVDD_SYNTH1), U2.25 (AVDD_PFD_CHP), U2.27 (AVDD_SYNTH2), U2.28 (AVDD_XOSC)
RADIO_GND: ANT_868.1, ANT_868.2, ANT_868.3, ANT_868.4, C11.2, C51.2, C61.2, C121.2, C131.2, C151.2, C171.2, C172.2, C211.2, C221.2, C251.2, C261.2, C271.2, C281.2, C291.2, C301.2, C302.2, C311.2, F1.5 (GND), F1.6 (GND), F1.8 (GND), F1.9 (GND), F1.10 (GND), JP1.1, R12.1, R12.2, R141.1, U2.32 (EXT_XOSC), U2.33 (EPAD), U2.V (EPAD), U2.V_2 (EPAD), U2.V_3 (EPAD), U2.V_4 (EPAD), U2.V_5 (EPAD), U2.V_6 (EPAD), U2.V_7 (EPAD), U2.V_8 (EPAD), U2.V_9 (EPAD), U2.V_10 (EPAD), U2.V_11 (EPAD), U2.V_12 (EPAD), U2.V_13 (EPAD), U2.V_14 (EPAD), U2.V_15 (EPAD), U2.V_16 (EPAD), X1.2, X1.4
RADIO_GPIO0_A: JP1.6, U2.10 (GPIO0)
RADIO_GPIO0_A1: JP3.6, U1.10 (GPIO0)
RADIO_GPIO0_D: JP6.6, U3.10 (GPIO0)
RADIO_GPIO0_D1: JP5.6, U4.10 (GPIO0)
RADIO_GPIO2_A: JP2.1, U2.4 (GPIO2)
RADIO_GPIO2_A1: JP4.1, U1.4 (GPIO2)
RADIO_GPIO2_D: JP7.1, U3.4 (GPIO2)
RADIO_GPIO2_D1: JP8.1, U4.4 (GPIO2)
RADIO_GPIO3_A: JP2.2, U2.3 (GPIO3)
RADIO_GPIO3_A1: JP4.2, U1.3 (GPIO3)
RADIO_GPIO3_D: JP7.2, U3.3 (GPIO3)
RADIO_GPIO3_D1: JP8.2, U4.3 (GPIO3)
RADIO_RESET_N_A: JP1.7, U2.2 (RESET_N)
RADIO_RESET_N_A1: JP3.7, U1.2 (RESET_N)
RADIO_RESET_N_D: JP6.7, U3.2 (RESET_N)
RADIO_RESET_N_D1: JP5.7, U4.2 (RESET_N)
RADIO_SPI_CLK_A: JP1.5, U2.8 (SCLK)
RADIO_SPI_CLK_A1: JP3.5, U1.8 (SCLK)
RADIO_SPI_CLK_D: JP6.5, U3.8 (SCLK)
RADIO_SPI_CLK_D1: JP5.5, U4.8 (SCLK)
RADIO_SPI_CSN_A: JP1.2, U2.11 (CS_N)
RADIO_SPI_CSN_A1: JP3.2, U1.11 (CS_N)
RADIO_SPI_CSN_D: JP6.2, U3.11 (CS_N)
RADIO_SPI_CSN_D1: JP5.2, U4.11 (CS_N)
RADIO_SPI_MISO_A: JP1.3, U2.9 (DO)
RADIO_SPI_MISO_A1: JP3.3, U1.9 (DO)
RADIO_SPI_MISO_D: JP6.3, U3.9 (DO)
RADIO_SPI_MISO_D1: JP5.3, U4.9 (DO)
RADIO_SPI_MOSI_A: JP1.4, U2.7 (SI)
RADIO_SPI_MOSI_A1: JP3.4, U1.7 (SI)
RADIO_SPI_MOSI_D: JP6.4, U3.7 (SI)
RADIO_SPI_MOSI_D1: JP5.4, U4.7 (SI)
VCC: C2.1, C4.1, C6.1, C7.1, C9.1, C10.1, C16.1, C17.1, C18.1, C19.2, C20.1, C21.1, JP3.8, R2.1, U1.1 (VDD_GUARD), U1.5 (DVDD_2), U1.12 (DVDD), U1.13 (AVDD_IF), U1.15 (AVDD_RF), U1.22 (AVDD_SYNTH1), U1.25 (AVDD_PFD_CHP), U1.27 (AVDD_SYNTH2), U1.28 (AVDD_XOSC)
VDD: C43.1, C45.1, C47.1, C48.1, C50.1, C52.1, C57.1, C58.1, C59.1, C60.2, C62.1, C63.1, JP5.8, R7.1, U4.1 (VDD_GUARD), U4.5 (DVDD_2), U4.12 (DVDD), U4.13 (AVDD_IF), U4.15 (AVDD_RF), U4.22 (AVDD_SYNTH1), U4.25 (AVDD_PFD_CHP), U4.27 (AVDD_SYNTH2), U4.28 (AVDD_XOSC)

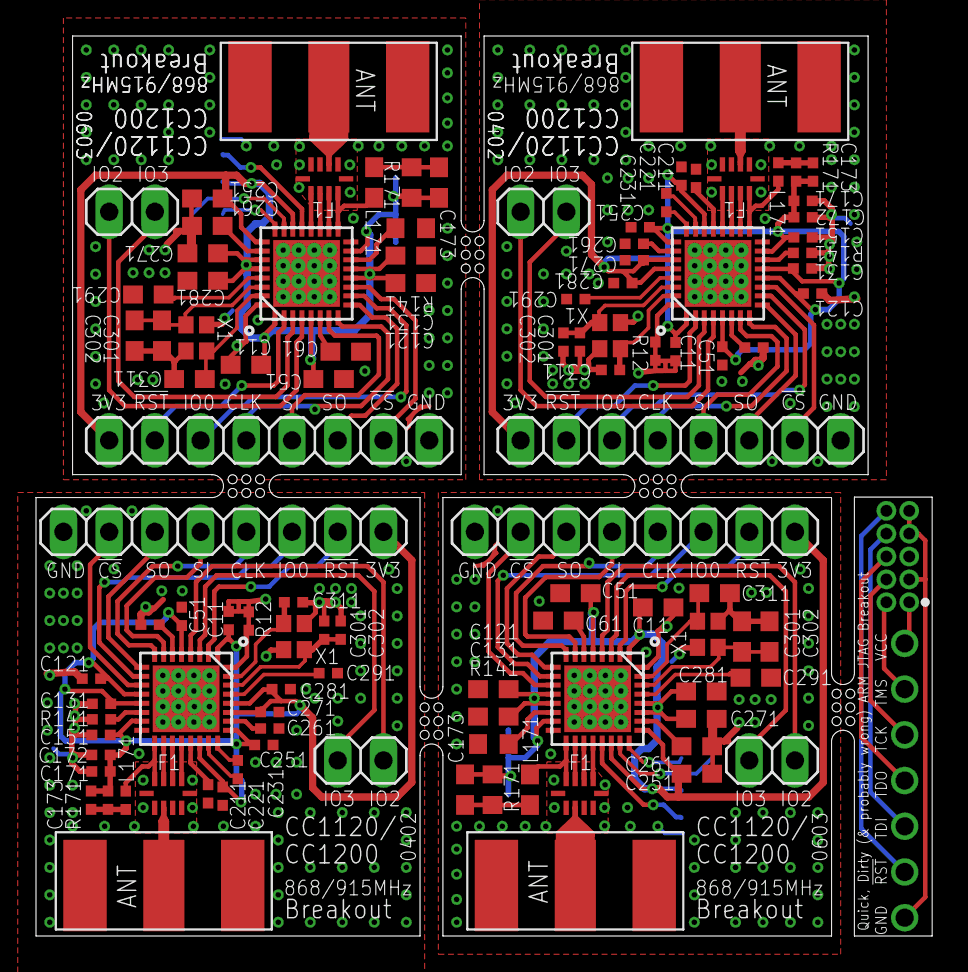
[picture p10: board CC1200_Breakout.brd from above]

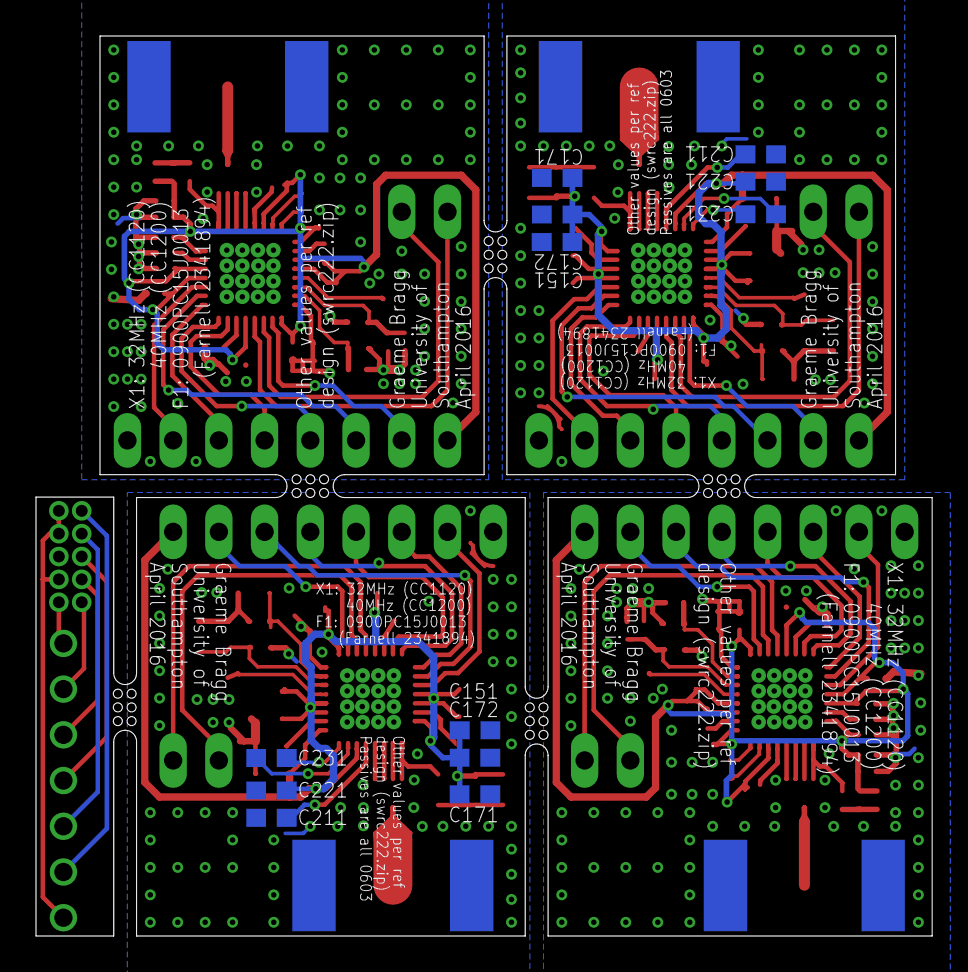
[picture p11: board CC1200_Breakout.brd from below]

Board: 4 copper layers, 49.8 x 50.0 mm, 118 parts (12 on the bottom side), 100 nets.
