feshie/ms2/Muntjac/Muntjac.brd

## EAGLE design Muntjac/Muntjac.brd (2016-04-16)

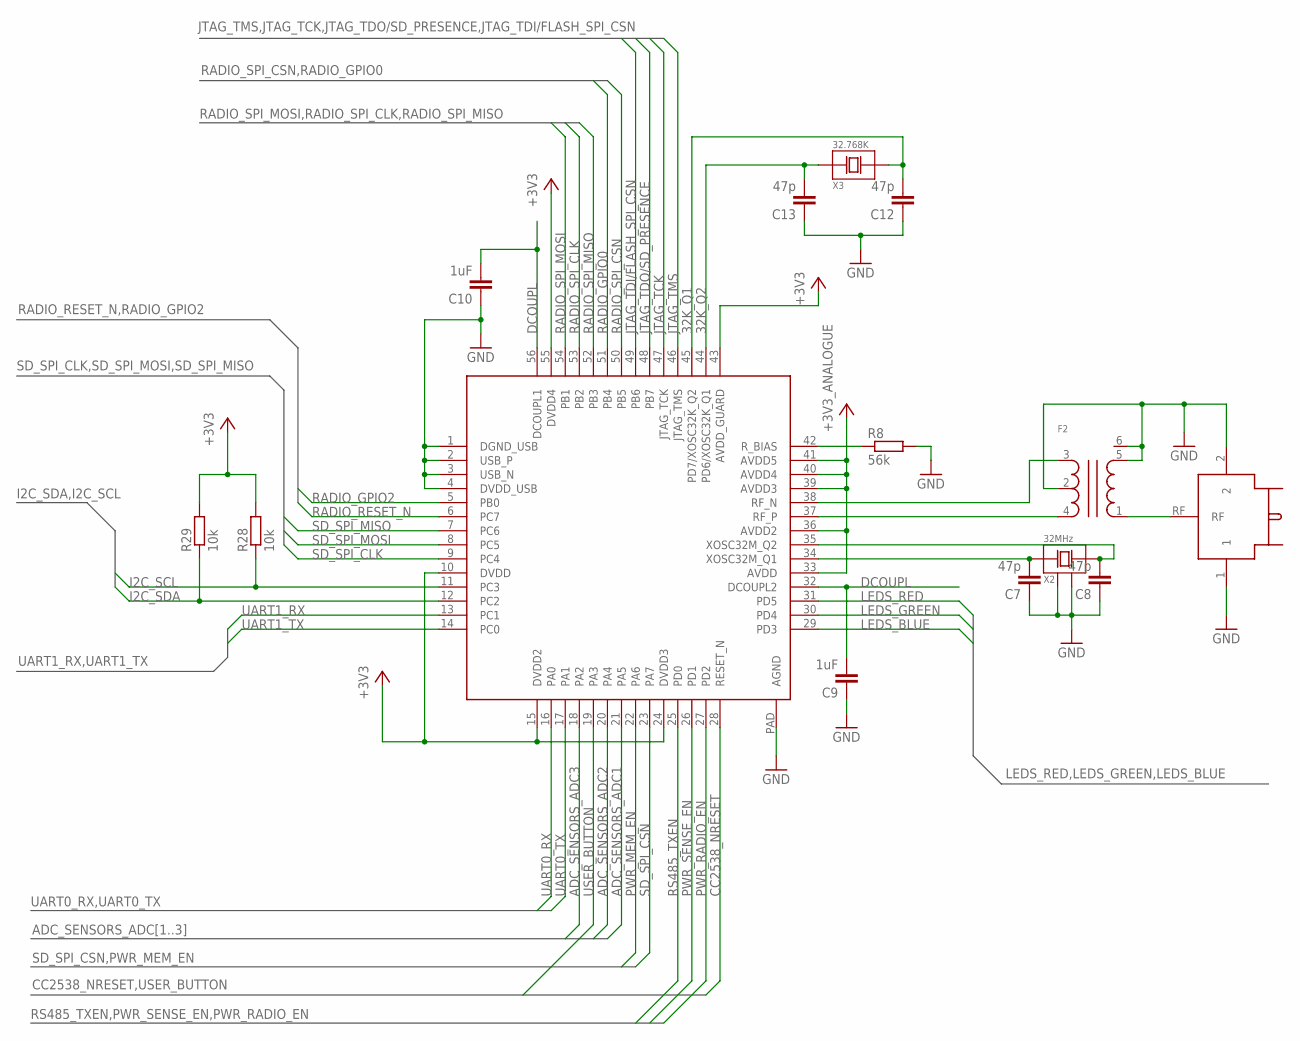
[picture p12: schematic Muntjac.sch, sheet 1, CC2538 Core]

Parts:
ANT: UFL; UFL-HIROSE
C7, C8, C12, C13: 47p; C0603
C9, C10: 1uF; C0603
F2: BALUN-2.4G; 2450BM15A0015
R8: 56k; R0603
R28, R29: 10k; R0603
U1: CC2538; QFN56
X2: 32MHz; XTAL-3.2X2.5
X3: 32.768K; XTAL-3.2X1.5

Connections:
2.4G: ANT.RF, F2.1
32K_Q1: C12.2, U1.45 (PD7/XOSC32K_Q2), X3.2 (3)
32K_Q2: C13.2, U1.44 (PD6/XOSC32K_Q1), X3.1
32M_Q1: C7.2, U1.34 (XOSC32M_Q1), X2.1
32M_Q2: C8.2, U1.35 (XOSC32M_Q2), X2.3
+3V3: R28.2, R29.2, U1.10 (DVDD), U1.15 (DVDD2), U1.24 (DVDD3), U1.43 (AVDD_GUARD), U1.55 (DVDD4); also elsewhere on the board
+3V3_ANALOGUE: U1.33 (AVDD), U1.36 (AVDD2), U1.39 (AVDD3), U1.40 (AVDD4), U1.41 (AVDD5); also elsewhere on the board
ADC_SENSORS_ADC1: U1.21 (PA5); also elsewhere on the board
ADC_SENSORS_ADC2: U1.20 (PA4); also elsewhere on the board
ADC_SENSORS_ADC3: U1.18 (PA2); also elsewhere on the board
CC2538_NRESET: U1.28 (RESET_N); also elsewhere on the board
DCOUPL: C9.2, C10.2, U1.32 (DCOUPL2), U1.56 (DCOUPL1)
GND: ANT.1, ANT.2, C7.1, C8.1, C9.1, C10.1, C12.1, C13.1, F2.2, F2.5, F2.6, R8.2, U1.1 (DGND_USB), U1.2 (USB_P), U1.3 (USB_N), U1.4 (DVDD_USB), U1.PAD (AGND), X2.2, X2.4; also elsewhere on the board
I2C_SCL: R28.1, U1.11 (PC3); also elsewhere on the board
I2C_SDA: R29.1, U1.12 (PC2); also elsewhere on the board
JTAG_TCK: U1.47 (JTAG_TCK); also elsewhere on the board
JTAG_TDI/FLASH_SPI_CSN: U1.49 (PB6); also elsewhere on the board
JTAG_TDO/SD_PRESENCE: U1.48 (PB7); also elsewhere on the board
JTAG_TMS: U1.46 (JTAG_TMS); also elsewhere on the board
LEDS_BLUE: U1.29 (PD3); also elsewhere on the board
LEDS_GREEN: U1.30 (PD4); also elsewhere on the board
LEDS_RED: U1.31 (PD5); also elsewhere on the board
unnamed: R8.1, U1.42 (R_BIAS)
unnamed: F2.4, U1.37 (RF_P)
unnamed: F2.3, U1.38 (RF_N)
PWR_MEM_EN: U1.22 (PA6); also elsewhere on the board
PWR_RADIO_EN: U1.27 (PD2); also elsewhere on the board
PWR_SENSE_EN: U1.26 (PD1); also elsewhere on the board
RADIO_GPIO0: U1.51 (PB4); also elsewhere on the board
RADIO_GPIO2: U1.5 (PB0); also elsewhere on the board
RADIO_RESET_N: U1.6 (PC7); also elsewhere on the board
RADIO_SPI_CLK: U1.53 (PB2); also elsewhere on the board
RADIO_SPI_CSN: U1.50 (PB5); also elsewhere on the board
RADIO_SPI_MISO: U1.52 (PB3); also elsewhere on the board
RADIO_SPI_MOSI: U1.54 (PB1); also elsewhere on the board
RS485_TXEN: U1.25 (PD0); also elsewhere on the board
SD_SPI_CLK: U1.9 (PC4); also elsewhere on the board
SD_SPI_CSN: U1.23 (PA7); also elsewhere on the board
SD_SPI_MISO: U1.7 (PC6); also elsewhere on the board
SD_SPI_MOSI: U1.8 (PC5); also elsewhere on the board
UART0_RX: U1.16 (PA0); also elsewhere on the board
UART0_TX: U1.17 (PA1); also elsewhere on the board
UART1_RX: U1.13 (PC1); also elsewhere on the board
UART1_TX: U1.14 (PC0); also elsewhere on the board
USER_BUTTON: U1.19 (PA3); also elsewhere on the board

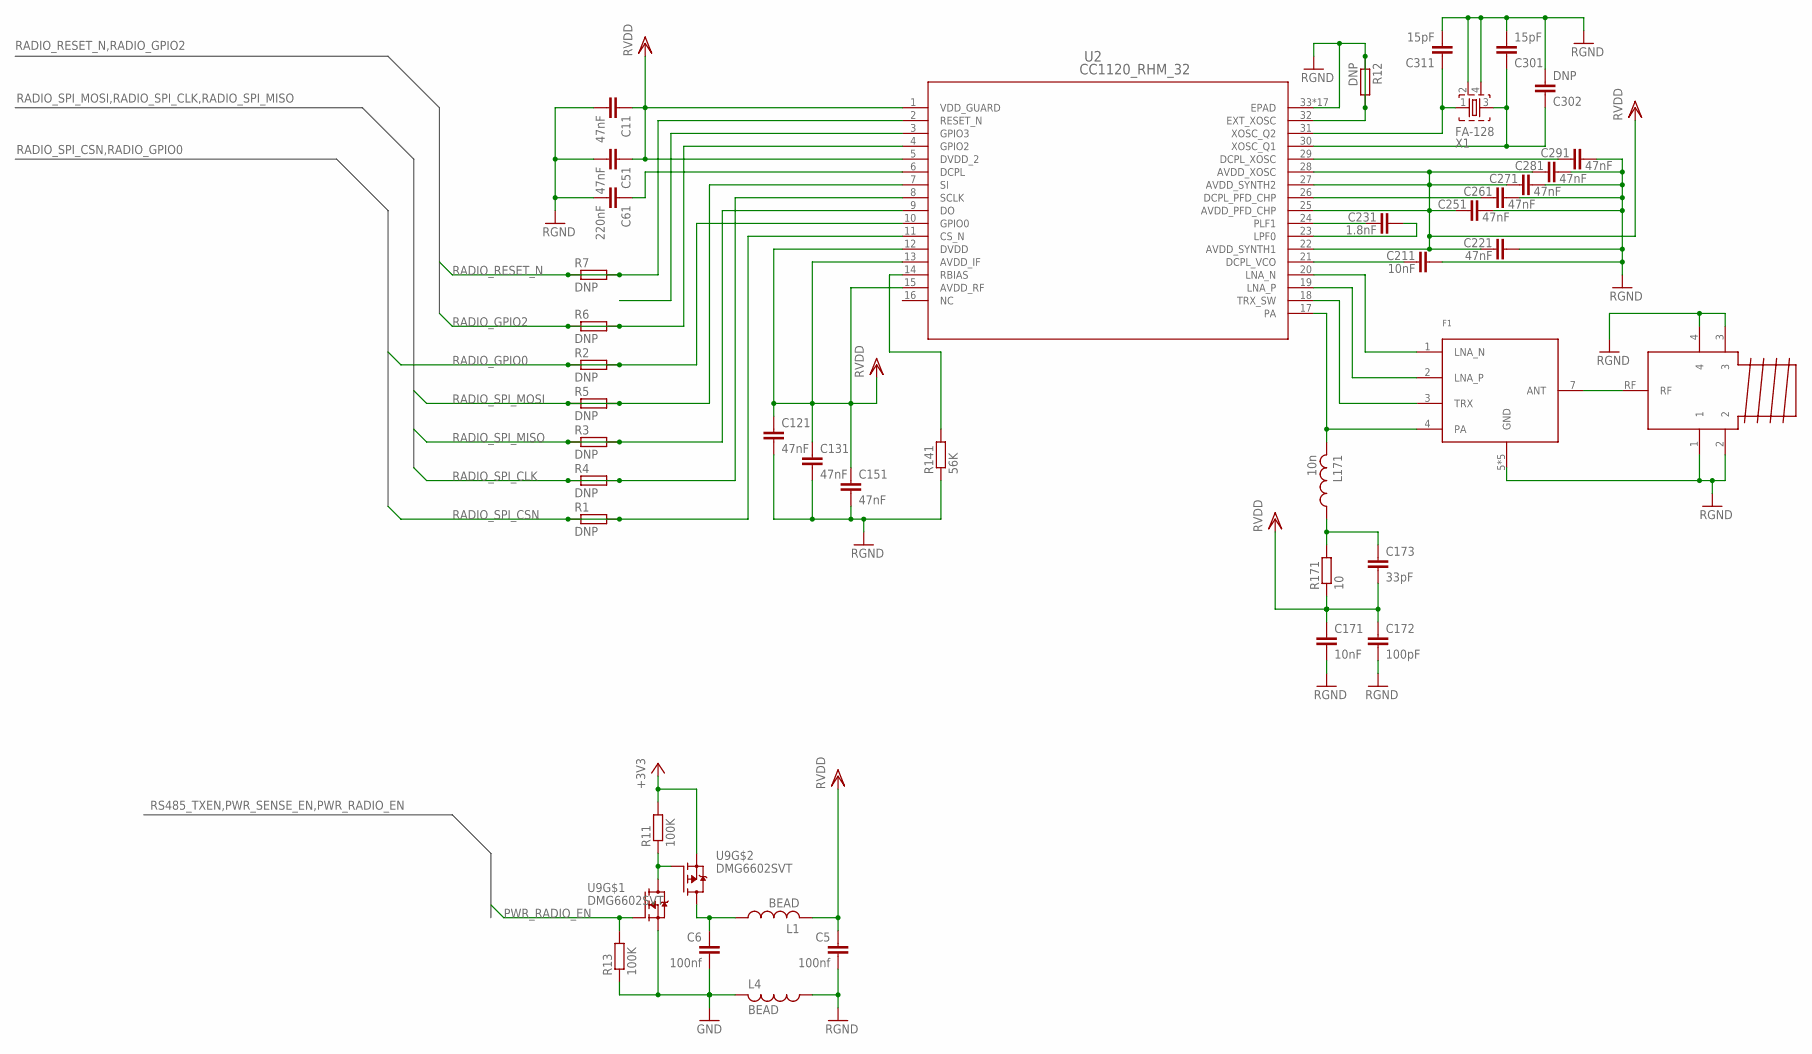
[picture p13: schematic Muntjac.sch, sheet 2, CC1200]

Parts:
ANT_868: SMA; JOHNSON_142-0701-806
C5, C6: 100nf; C0603
C11, C51, C121, C131, C151, C221, C251, C261, C271, C281, C291: 47nF; C0402_SMALL
C61: 220nF; C0402_SMALL
C171, C211: 10nF; C0402_SMALL
C172: 100pF; C0402_SMALL
C173: 33pF; C0402_SMALL
C231: 1.8nF; C0402_SMALL
C301, C311: 15pF; C0402_SMALL
C302: DNP; C0402_SMALL
F1: 0900PC15J0013
L1, L4: BEAD; C0603
L171: 10n; C0402_SMALL
R1, R2, R3, R4, R5, R6, R7: DNP; R0402
R11, R13: 100K; R0603
R12: DNP; C0402_SMALL
R141: 56K; C0402_SMALL
R171: 10; C0402_SMALL
U2: CC1120_RHM_32; RHM32_3P7X3P7
U9: DMG6602SVT; TSOT26
X1: FA-128

Connections:
+3V3: R11.2, U9.P$2 (S); also elsewhere on the board
GND: C6.2, L4.2, R13.1, U9.P$5 (S); also elsewhere on the board
unnamed: C231.1, U2.24 (PLF1)
unnamed: C231.2, U2.23 (LPF0)
unnamed: C211.1, U2.21 (DCPL_VCO)
unnamed: C61.1, U2.6 (DCPL)
unnamed: C261.1, U2.26 (DCPL_PFD_CHP)
unnamed: C311.1, U2.31 (XOSC_Q2), X1.1
unnamed: C301.1, C302.1, U2.30 (XOSC_Q1), X1.3
unnamed: C291.1, U2.29 (DCPL_XOSC)
unnamed: F1.1 (LNA_N), U2.20 (LNA_N)
unnamed: F1.2 (LNA_P), U2.19 (LNA_P)
unnamed: ANT_868.RF, F1.7 (ANT)
unnamed: F1.3 (TRX), U2.18 (TRX_SW)
unnamed: R141.2, U2.14 (RBIAS)
unnamed: F1.4 (PA), L171.2, U2.17 (PA)
unnamed: C173.1, L171.1, R171.2
unnamed: C6.1, L1.1, U9.P$4 (D)
unnamed: R11.1, U9.P$3 (G), U9.P$6 (D)
PWR_RADIO_EN: R13.2, U9.P$1 (G); also elsewhere on the board
RADIO_GPIO0: R2.1, R2.2, U2.10 (GPIO0); also elsewhere on the board
RADIO_GPIO2: R6.1, R6.2, U2.4 (GPIO2); also elsewhere on the board
RADIO_GPIO3: U2.3 (GPIO3)
RADIO_RESET_N: R7.1, R7.2, U2.2 (RESET_N); also elsewhere on the board
RADIO_SPI_CLK: R4.1, R4.2, U2.8 (SCLK); also elsewhere on the board
RADIO_SPI_CSN: R1.1, R1.2, U2.11 (CS_N); also elsewhere on the board
RADIO_SPI_MISO: R3.1, R3.2, U2.9 (DO); also elsewhere on the board
RADIO_SPI_MOSI: R5.1, R5.2, U2.7 (SI); also elsewhere on the board
RGND: ANT_868.1, ANT_868.2, ANT_868.3, ANT_868.4, C5.2, C11.2, C51.2, C61.2, C121.2, C131.2, C151.2, C171.2, C172.2, C211.2, C221.2, C251.2, C261.2, C271.2, C281.2, C291.2, C301.2, C302.2, C311.2, F1.5 (GND), F1.6 (GND), F1.8 (GND), F1.9 (GND), F1.10 (GND), L4.1, R12.1, R12.2, R141.1, U2.32 (EXT_XOSC), U2.33 (EPAD), U2.V (EPAD), U2.V_2 (EPAD), U2.V_3 (EPAD), U2.V_4 (EPAD), U2.V_5 (EPAD), U2.V_6 (EPAD), U2.V_7 (EPAD), U2.V_8 (EPAD), U2.V_9 (EPAD), U2.V_10 (EPAD), U2.V_11 (EPAD), U2.V_12 (EPAD), U2.V_13 (EPAD), U2.V_14 (EPAD), U2.V_15 (EPAD), U2.V_16 (EPAD), X1.2, X1.4
RVDD: C5.1, C11.1, C51.1, C121.1, C131.1, C151.1, C171.1, C172.1, C173.2, C221.1, C251.1, C271.1, C281.1, L1.2, R171.1, U2.1 (VDD_GUARD), U2.5 (DVDD_2), U2.12 (DVDD), U2.13 (AVDD_IF), U2.15 (AVDD_RF), U2.22 (AVDD_SYNTH1), U2.25 (AVDD_PFD_CHP), U2.27 (AVDD_SYNTH2), U2.28 (AVDD_XOSC)
