feshie/ms2/Muntjac/Muntjac.brd

## EAGLE design Muntjac/Muntjac.brd (continued)

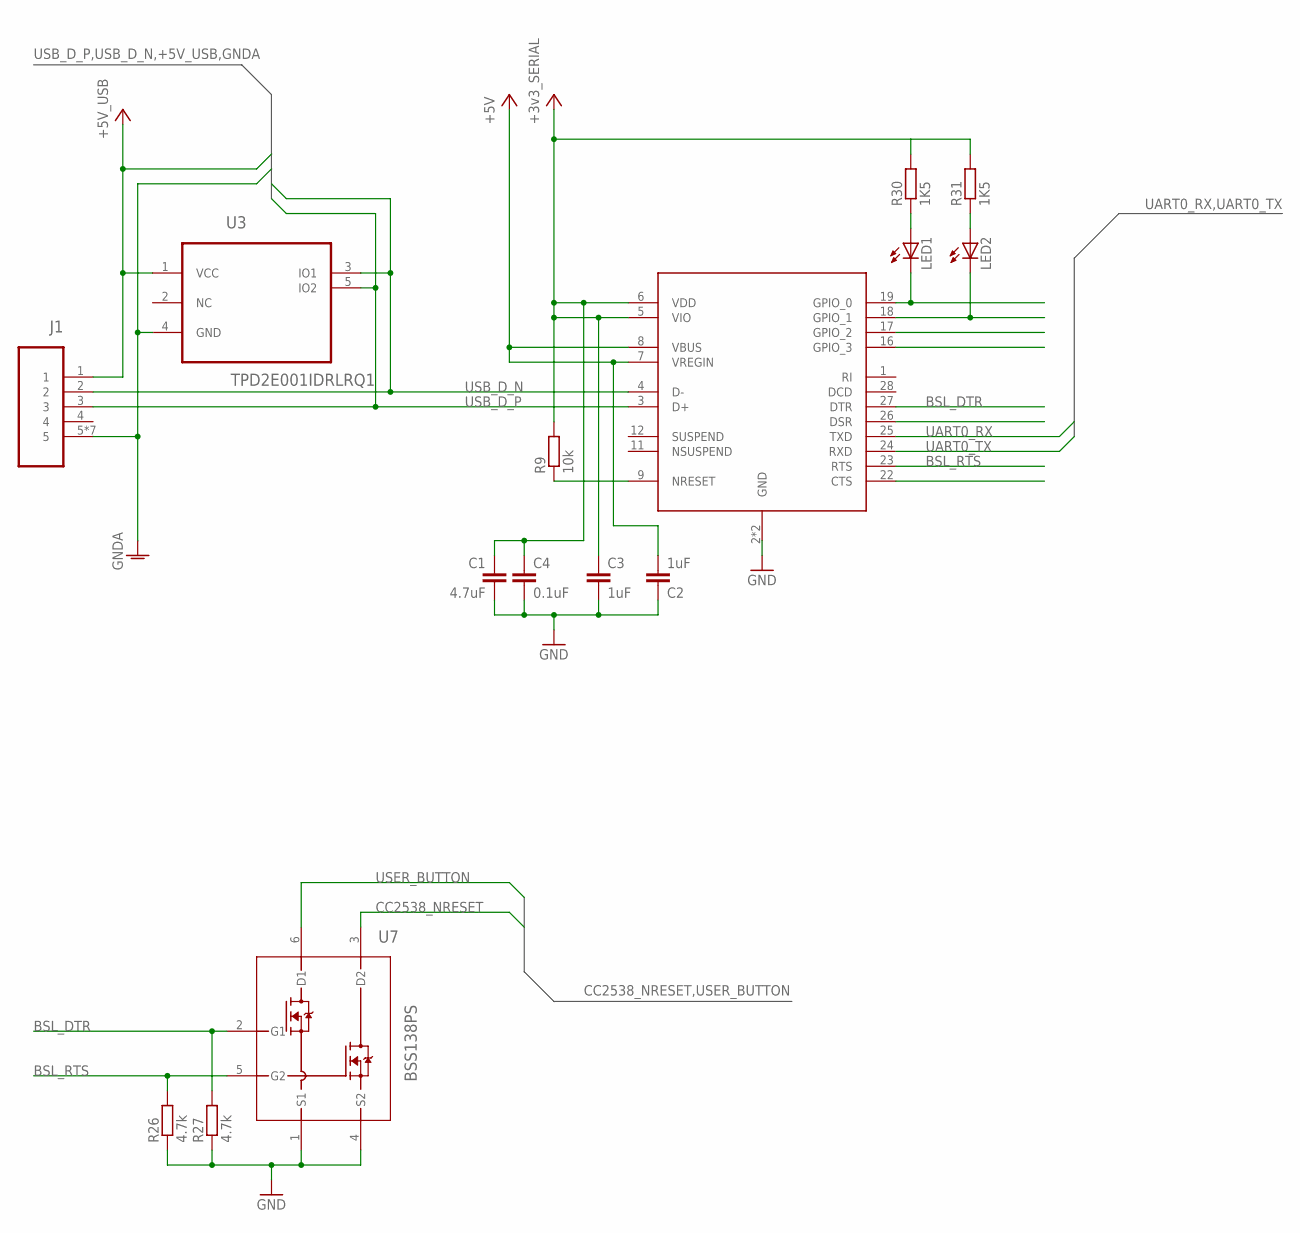
[picture p14: schematic Muntjac.sch, sheet 3, BSL/Serial Interface]

Parts:
C1: 4.7uF; C0603
C2, C3: 1uF; C0603
C4: 0.1uF; C0603
J1: 47346-0001; MOLEX_47346-0001
LED1, LED2: LEDSML0603; SML0603
R9: 10k; R0603
R26, R27: 4.7k; R0603
R30, R31: 1K5; R0603
U3: TPD2E001IDRLRQ1; SOT50P160X60-5N
U4: CP2103; QFN50P500X500X100-29N
U7: BSS138PS; SOT65P210X110-6N

Connections:
+3V3_SERIAL: C1.1, C3.1, C4.1, R9.2, R30.2, R31.2, U4.5 (VIO), U4.6 (VDD); also elsewhere on the board
+5V: C2.2, U4.7 (VREGIN), U4.8 (VBUS); also elsewhere on the board
+5V_USB: J1.1, U3.1 (VCC); also elsewhere on the board
BSL_DTR: R27.2, U4.27 (DTR), U7.2 (G1)
BSL_RTS: R26.2, U4.23 (RTS), U7.5 (G2)
CC2538_NRESET: U7.3 (D2); also elsewhere on the board
GND: C1.2, C2.1, C3.2, C4.2, R26.1, R27.1, U4.2 (GND), U4.29 (GND), U7.1 (S1), U7.4 (S2); also elsewhere on the board
GNDA: J1.5, J1.M1 (5), J1.M2 (5), J1.M3 (5), J1.M4 (5), J1.M5 (5), J1.M6 (5), U3.4 (GND); also elsewhere on the board
unnamed: LED1.C, U4.19 (GPIO_0)
unnamed: LED2.C, U4.18 (GPIO_1)
unnamed: LED1.A, R30.1
unnamed: R9.1, U4.9 (NRESET)
unnamed: LED2.A, R31.1
UART0_RX: U4.25 (TXD); also elsewhere on the board
UART0_TX: U4.24 (RXD); also elsewhere on the board
USB_D_N: J1.2, U3.3 (IO1), U4.4 (D-); also elsewhere on the board
USB_D_P: J1.3, U3.5 (IO2), U4.3 (D+); also elsewhere on the board
USER_BUTTON: U7.6 (D1); also elsewhere on the board

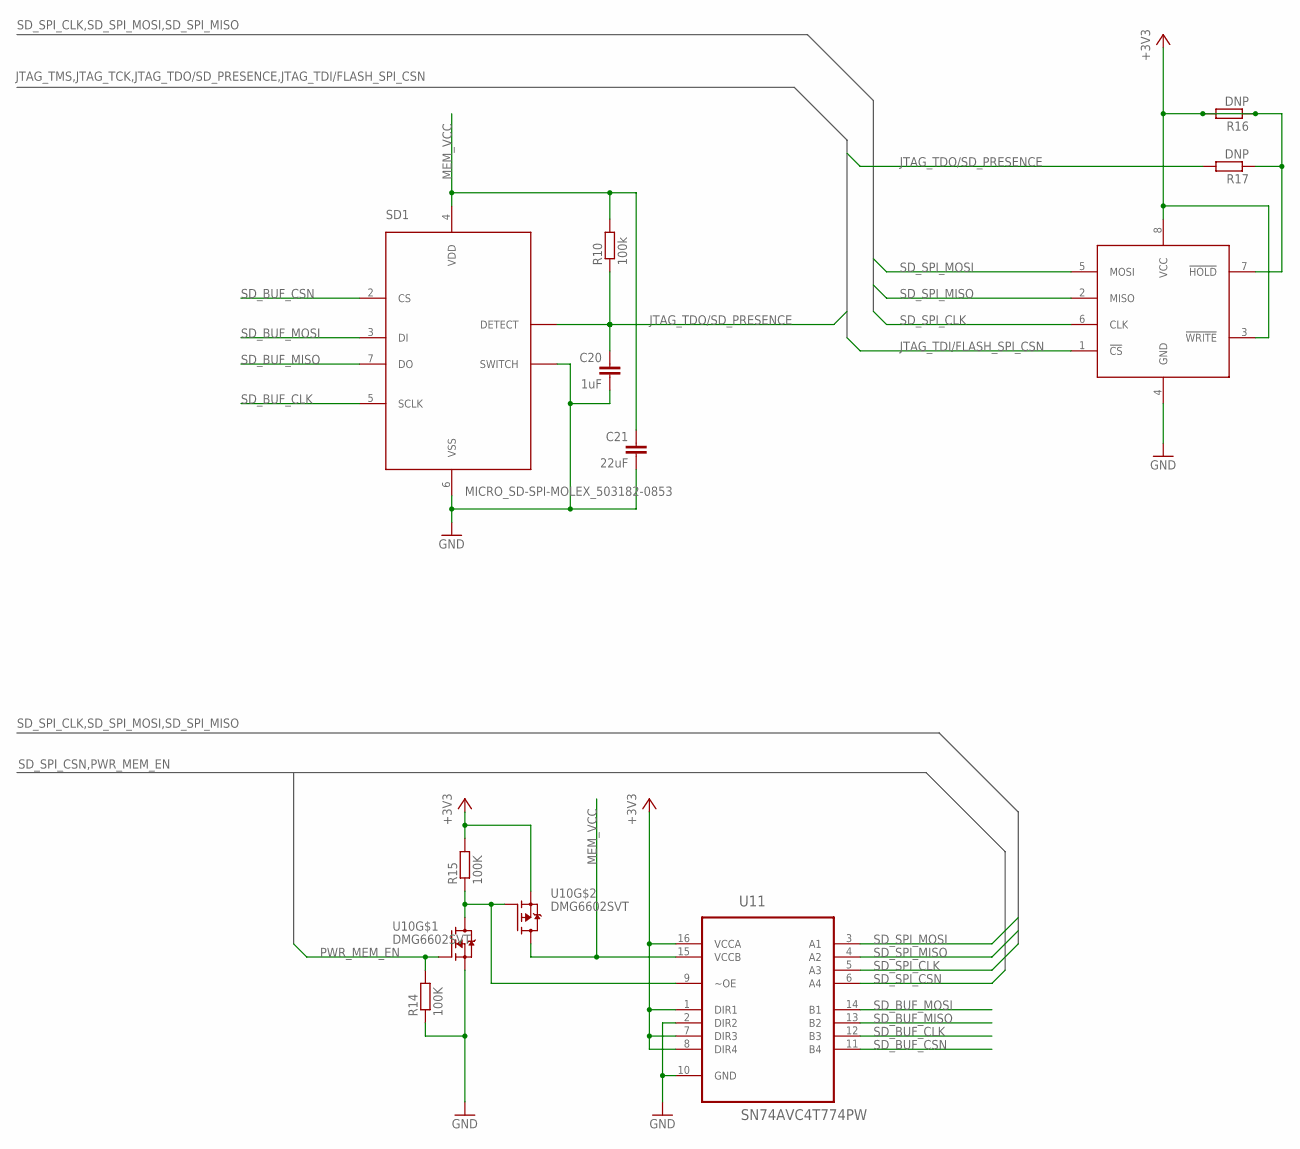
[picture p15: schematic Muntjac.sch, sheet 4, Storage]

Parts:
C20: 1uF; C0603
C21: 22uF; C0603
R10: 100k; R0603
R14, R15: 100K; R0603
R16, R17: DNP; R0402
SD1: MICRO_SD-SPI-MOLEX_503182-0853; MICRO_SD-MOLEX_503182-0853
U8: M25P16VMN6P; SOIC8
U10: DMG6602SVT; TSOT26
U11: SN74AVC4T774PW; SOP65P640X120-16N

Connections:
+3V3: R15.2, R16.1, R16.2, R17.1, U8.3 (!WRITE), U8.7 (!HOLD), U8.8 (VCC), U10.P$2 (S), U11.1 (DIR1), U11.7 (DIR3), U11.8 (DIR4), U11.16 (VCCA); also elsewhere on the board
GND: C20.2, C21.2, R14.1, SD1.6 (VSS), SD1.SWITCH, U8.4 (GND), U10.P$5 (S), U11.2 (DIR2), U11.10 (GND); also elsewhere on the board
JTAG_TDI/FLASH_SPI_CSN: U8.1 (!CS); also elsewhere on the board
JTAG_TDO/SD_PRESENCE: C20.1, R10.1, R17.2, SD1.DETECT; also elsewhere on the board
MEM_VCC: C21.1, R10.2, SD1.4 (VDD), U10.P$4 (D), U11.15 (VCCB)
unnamed: R15.1, U10.P$3 (G), U10.P$6 (D), U11.9 (~OE)
PWR_MEM_EN: R14.2, U10.P$1 (G); also elsewhere on the board
SD_BUF_CLK: SD1.5 (SCLK), U11.12 (B3)
SD_BUF_CSN: SD1.2 (CS), U11.11 (B4)
SD_BUF_MISO: SD1.7 (DO), U11.13 (B2)
SD_BUF_MOSI: SD1.3 (DI), U11.14 (B1)
SD_SPI_CLK: U8.6 (CLK), U11.5 (A3); also elsewhere on the board
SD_SPI_CSN: U11.6 (A4); also elsewhere on the board
SD_SPI_MISO: U8.2 (MISO), U11.4 (A2); also elsewhere on the board
SD_SPI_MOSI: U8.5 (MOSI), U11.3 (A1); also elsewhere on the board

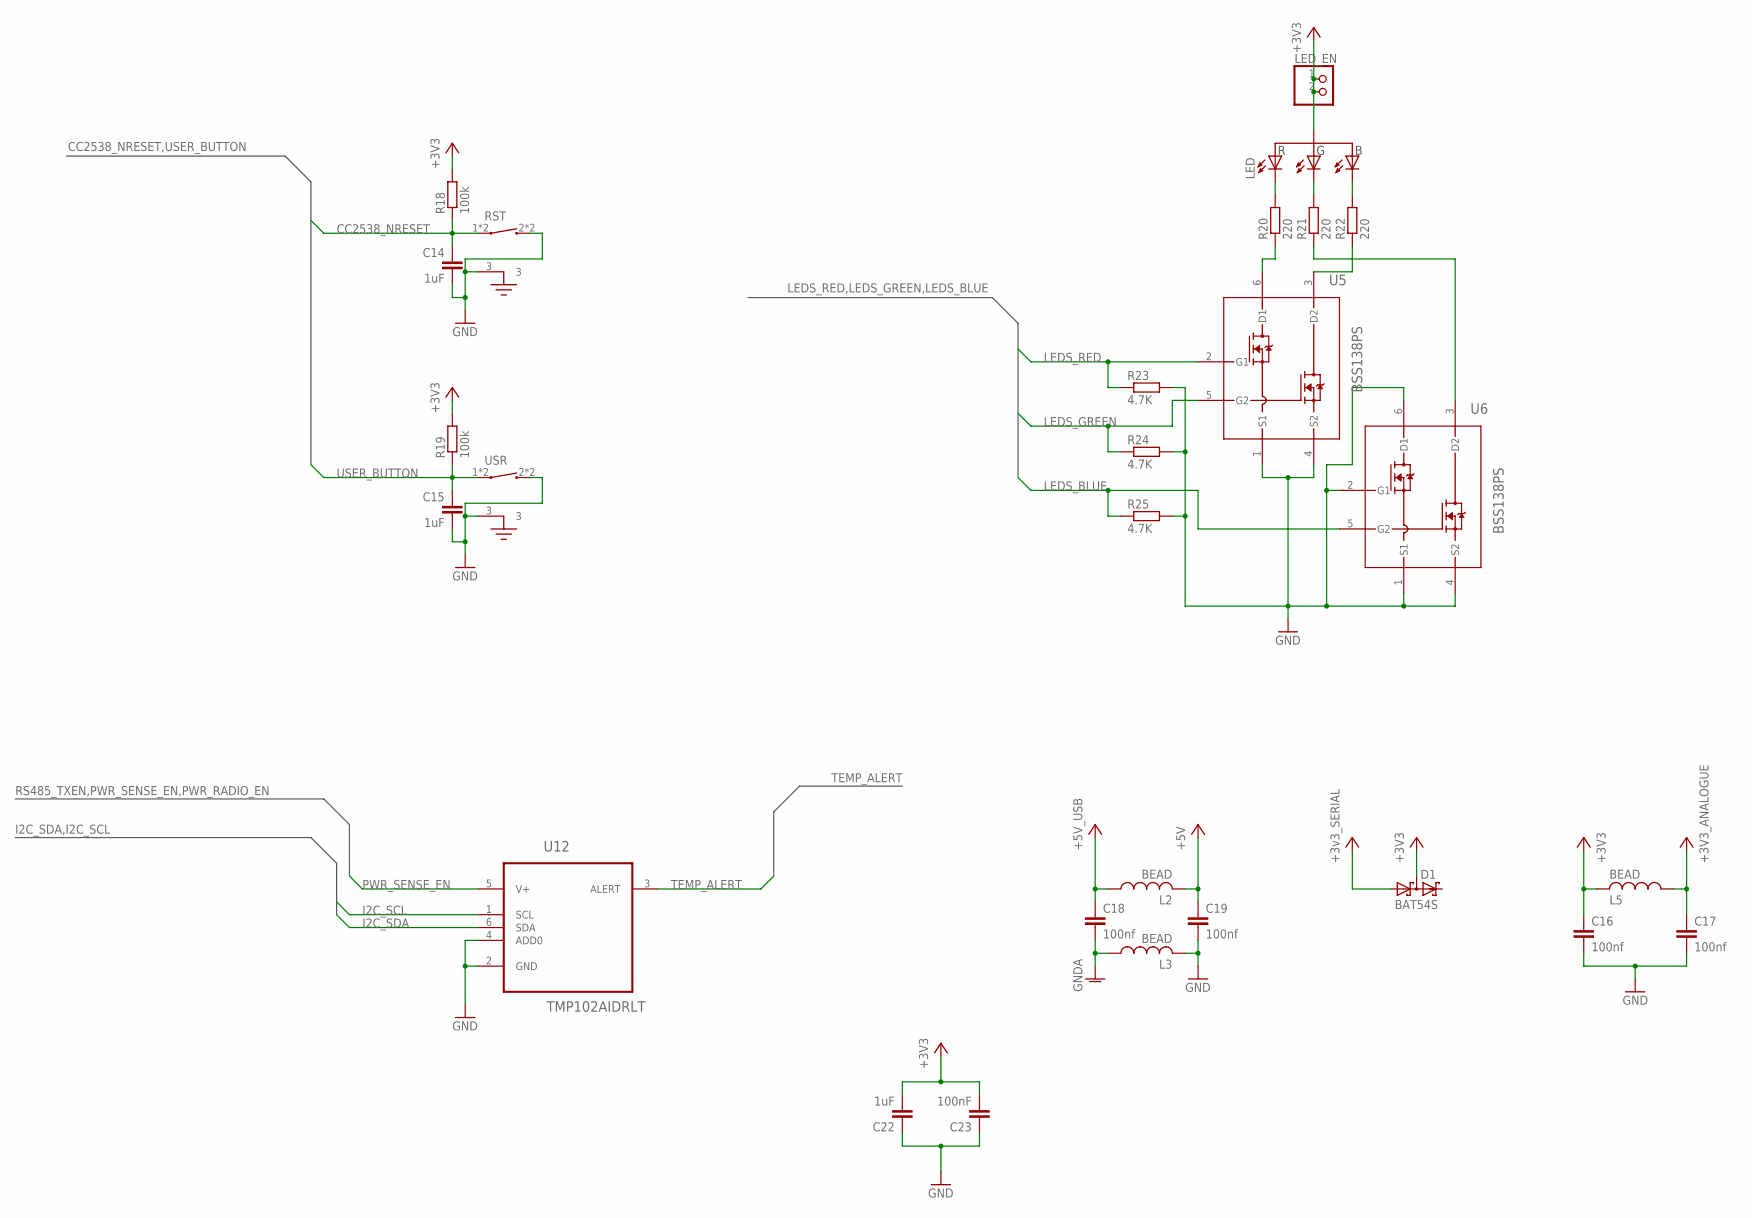
[picture p16: schematic Muntjac.sch, sheet 5, Power & HMI]

Parts:
C14, C15, C22: 1uF; C0603
C16, C17, C18, C19: 100nf; C0603
C23: 100nF; C0603
D1: BAT54S; SOT23
L2, L3, L5: BEAD; C0603
LED: CLV1A-FKB-CJ1M1F1BB7R4S3; PLCC-4_3.2X2.8
LED_EN: PINHD-1X2; 1X02
R18, R19: 100k; R0603
R20, R21, R22: 220; R0603
R23, R24, R25: 4.7K; R0603
RST: KMR2X1G; C&K-KMR-5MM
U5, U6: BSS138PS; SOT65P210X110-6N
U12: TMP102AIDRLT; SOT50P160X60-6N
USR: KMR2X1G; C&K-KMR-5MM

Connections:
+3V3: C16.1, C22.2, C23.2, D1.3 (C1A2), L5.2, LED.2, LED_EN.1, LED_EN.2, R18.2, R19.2; also elsewhere on the board
+3V3_ANALOGUE: C17.1, L5.1; also elsewhere on the board
+3V3_SERIAL: D1.1 (A1); also elsewhere on the board
+5V: C19.1, L2.2; also elsewhere on the board
+5V_USB: C18.1, L2.1; also elsewhere on the board
CC2538_NRESET: C14.1, R18.1, RST.1, RST.5 (1); also elsewhere on the board
GND: C14.2, C15.2, C16.2, C17.2, C19.2, C22.1, C23.1, L3.2, R23.2, R24.2, R25.2, RST.2, RST.3, RST.4 (2), U5.1 (S1), U5.4 (S2), U6.1 (S1), U6.2 (G1), U6.4 (S2), U6.6 (D1), U12.2 (GND), U12.4 (ADD0), USR.2, USR.3, USR.4 (2); also elsewhere on the board
GNDA: C18.2, L3.1; also elsewhere on the board
I2C_SCL: U12.1 (SCL); also elsewhere on the board
I2C_SDA: U12.6 (SDA); also elsewhere on the board
LEDS_BLUE: R25.1, U6.5 (G2); also elsewhere on the board
LEDS_GREEN: R24.1, U5.5 (G2); also elsewhere on the board
LEDS_RED: R23.1, U5.2 (G1); also elsewhere on the board
unnamed: LED.1, R20.2
unnamed: LED.3, R21.2
unnamed: LED.4, R22.2
unnamed: R20.1, U5.6 (D1)
unnamed: R21.1, U6.3 (D2)
unnamed: R22.1, U5.3 (D2)
PWR_SENSE_EN: U12.5 (V+); also elsewhere on the board
TEMP_ALERT: U12.3 (ALERT); also elsewhere on the board
USER_BUTTON: C15.1, R19.1, USR.1, USR.5 (1); also elsewhere on the board

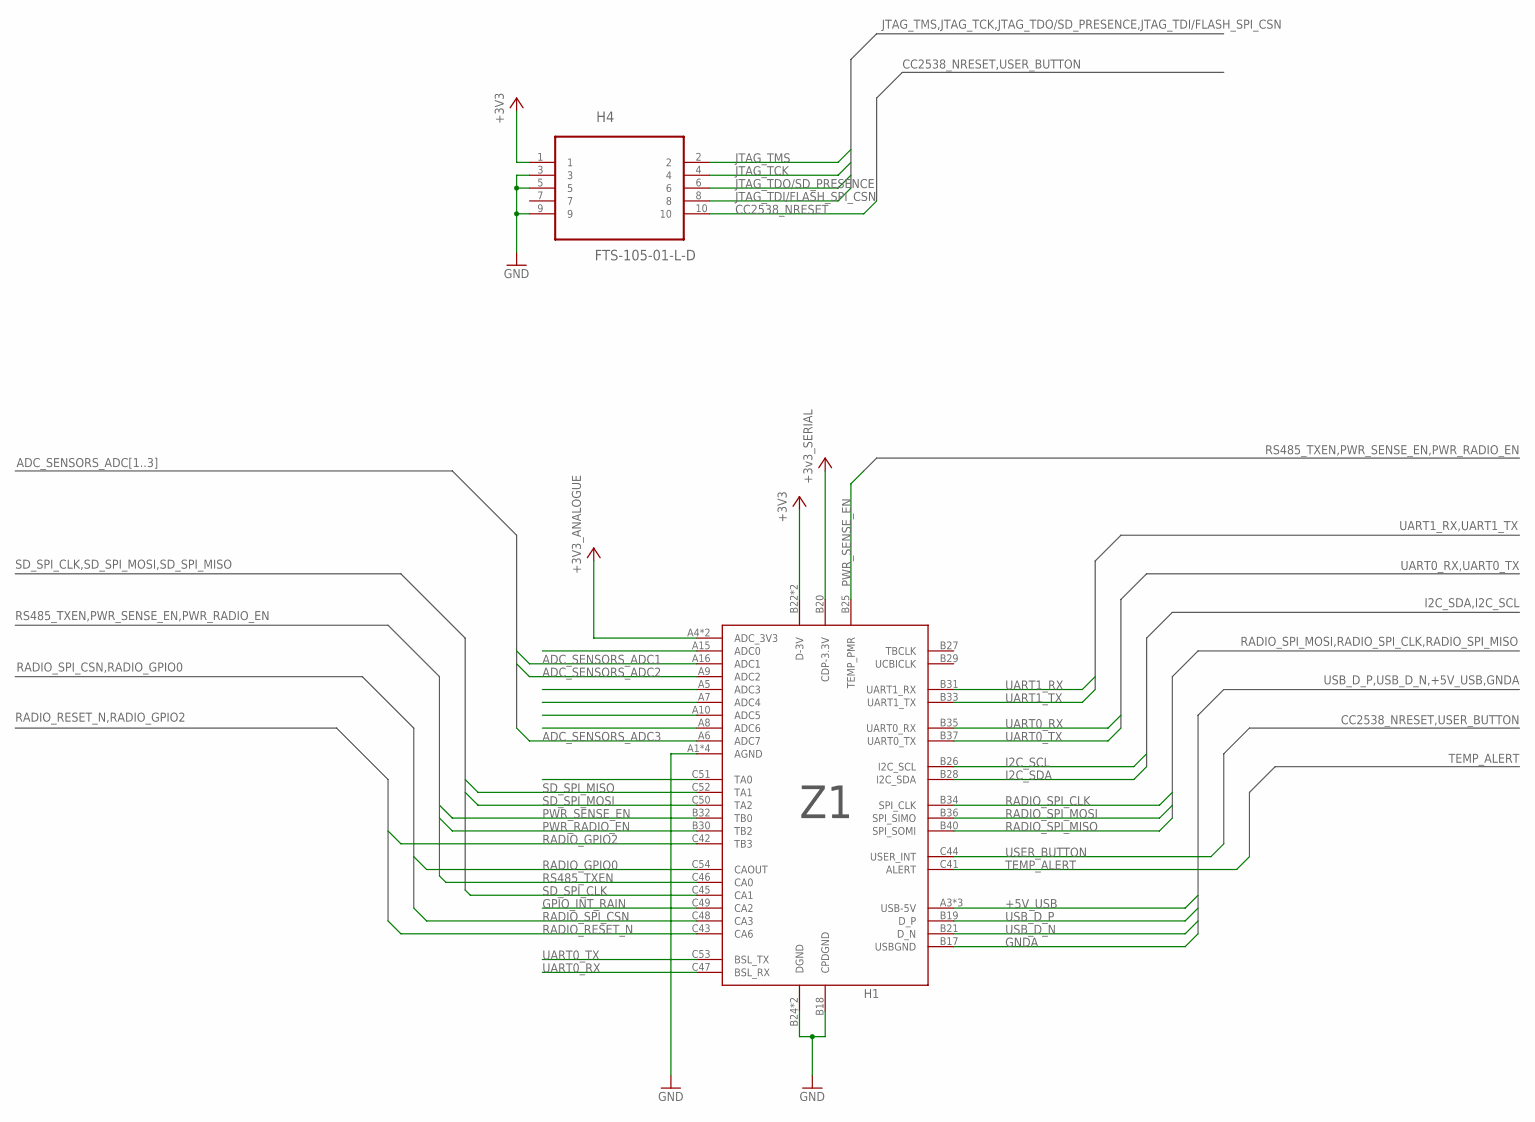
[picture p17: schematic Muntjac.sch, sheet 6, Headers]

Parts:
H1: Z1
H4: FTS-105-01-L-D; SAMTEC_FTS-105-01-L-D

Connections:
+3V3: H1.B22 (D-3V), H1.C40 (D-3V), H4.1; also elsewhere on the board
+3V3_ANALOGUE: H1.A4 (ADC_3V3), H1.A14 (ADC_3V3); also elsewhere on the board
+3V3_SERIAL: H1.B20 (CDP-3.3V); also elsewhere on the board
+5V_USB: H1.A3 (USB-5V), H1.A13 (USB-5V), H1.B23 (USB-5V); also elsewhere on the board
ADC_SENSORS_ADC1: H1.A16 (ADC1); also elsewhere on the board
ADC_SENSORS_ADC2: H1.A9 (ADC2); also elsewhere on the board
ADC_SENSORS_ADC3: H1.A6 (ADC7); also elsewhere on the board
CC2538_NRESET: H4.10; also elsewhere on the board
GND: H1.A1 (AGND), H1.A2 (AGND), H1.A11 (AGND), H1.A12 (AGND), H1.B18 (CPDGND), H1.B24 (DGND), H1.C39 (DGND), H4.3, H4.5, H4.9; also elsewhere on the board
GNDA: H1.B17 (USBGND); also elsewhere on the board
GPIO_INT_RAIN: H1.C49 (CA2)
I2C_SCL: H1.B26 (I2C_SCL); also elsewhere on the board
I2C_SDA: H1.B28 (I2C_SDA); also elsewhere on the board
JTAG_TCK: H4.4; also elsewhere on the board
JTAG_TDI/FLASH_SPI_CSN: H4.8; also elsewhere on the board
JTAG_TDO/SD_PRESENCE: H4.6; also elsewhere on the board
JTAG_TMS: H4.2; also elsewhere on the board
PWR_RADIO_EN: H1.B30 (TB2); also elsewhere on the board
PWR_SENSE_EN: H1.B25 (TEMP_PMR), H1.B32 (TB0); also elsewhere on the board
RADIO_GPIO0: H1.C54 (CAOUT); also elsewhere on the board
RADIO_GPIO2: H1.C42 (TB3); also elsewhere on the board
RADIO_RESET_N: H1.C43 (CA6); also elsewhere on the board
RADIO_SPI_CLK: H1.B34 (SPI_CLK); also elsewhere on the board
RADIO_SPI_CSN: H1.C48 (CA3); also elsewhere on the board
RADIO_SPI_MISO: H1.B40 (SPI_SOMI); also elsewhere on the board
RADIO_SPI_MOSI: H1.B36 (SPI_SIMO); also elsewhere on the board
RS485_TXEN: H1.C46 (CA0); also elsewhere on the board
SD_SPI_CLK: H1.C45 (CA1); also elsewhere on the board
SD_SPI_MISO: H1.C52 (TA1); also elsewhere on the board
SD_SPI_MOSI: H1.C50 (TA2); also elsewhere on the board
TEMP_ALERT: H1.C41 (ALERT); also elsewhere on the board
UART0_RX: H1.B35 (UART0_RX), H1.C47 (BSL_RX); also elsewhere on the board
UART0_TX: H1.B37 (UART0_TX), H1.C53 (BSL_TX); also elsewhere on the board
UART1_RX: H1.B31 (UART1_RX); also elsewhere on the board
UART1_TX: H1.B33 (UART1_TX); also elsewhere on the board
USB_D_N: H1.B21 (D_N); also elsewhere on the board
USB_D_P: H1.B19 (D_P); also elsewhere on the board
USER_BUTTON: H1.C44 (USER_INT); also elsewhere on the board

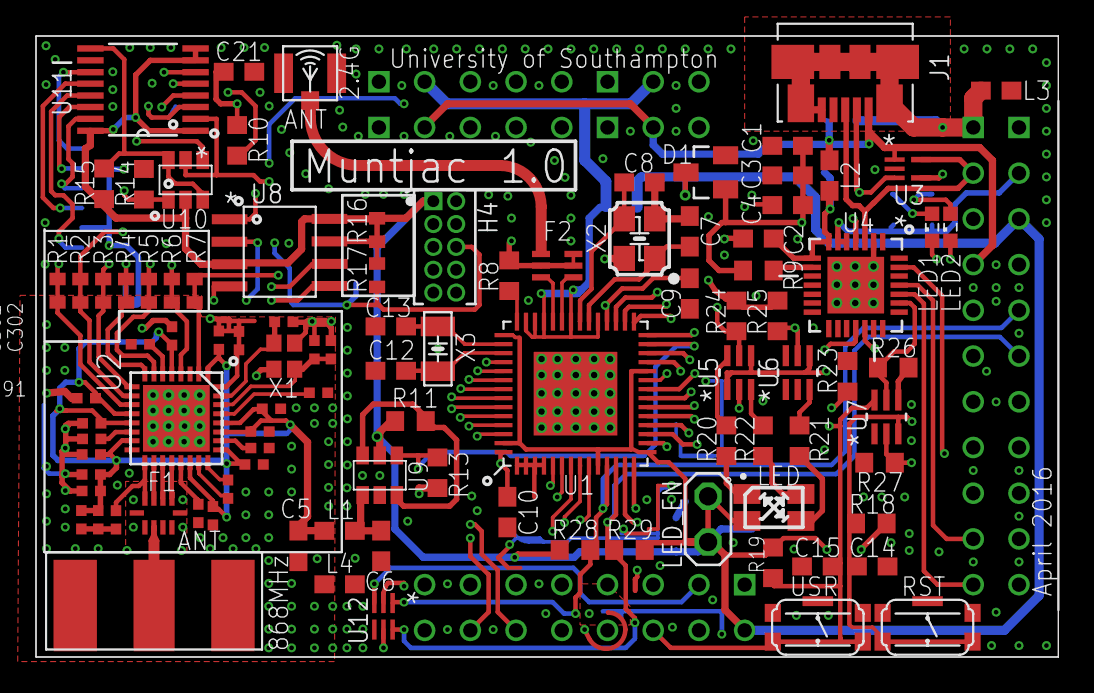
[picture p18: board Muntjac.brd from above]

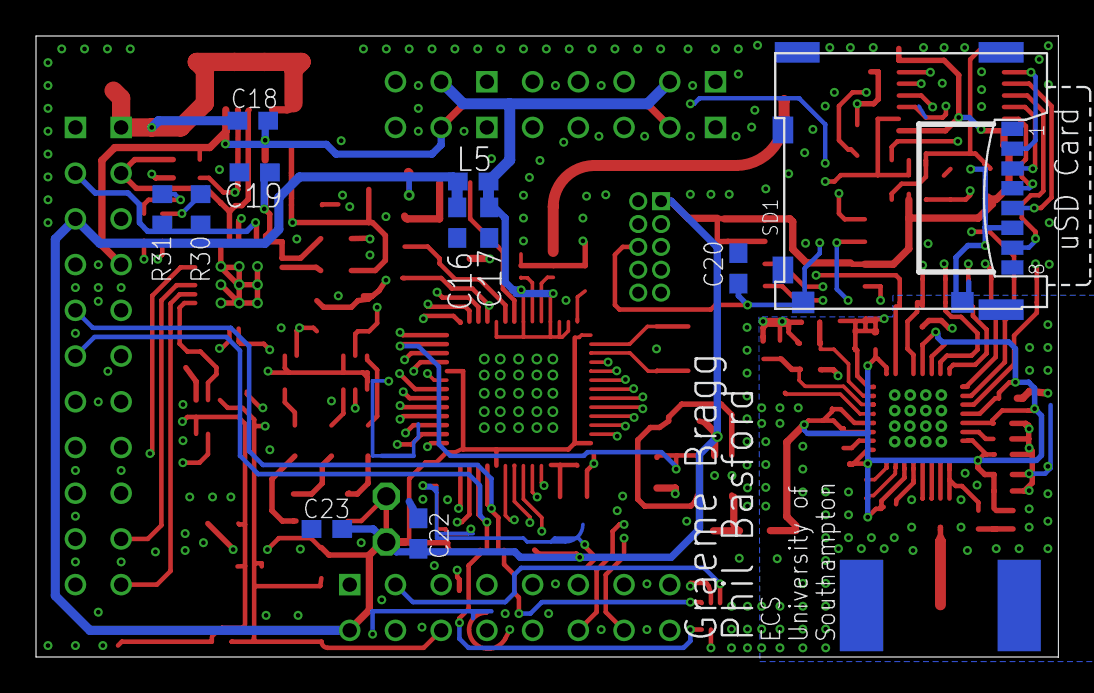
[picture p19: board Muntjac.brd from below]

Board: 4 copper layers, 56.8 x 34.5 mm, 111 parts (11 on the bottom side), 90 nets.
