feshie/ms2/cc1120/CC1120-chunk.brd

## EAGLE design cc1120/CC1120-chunk.brd (2016-03-26)

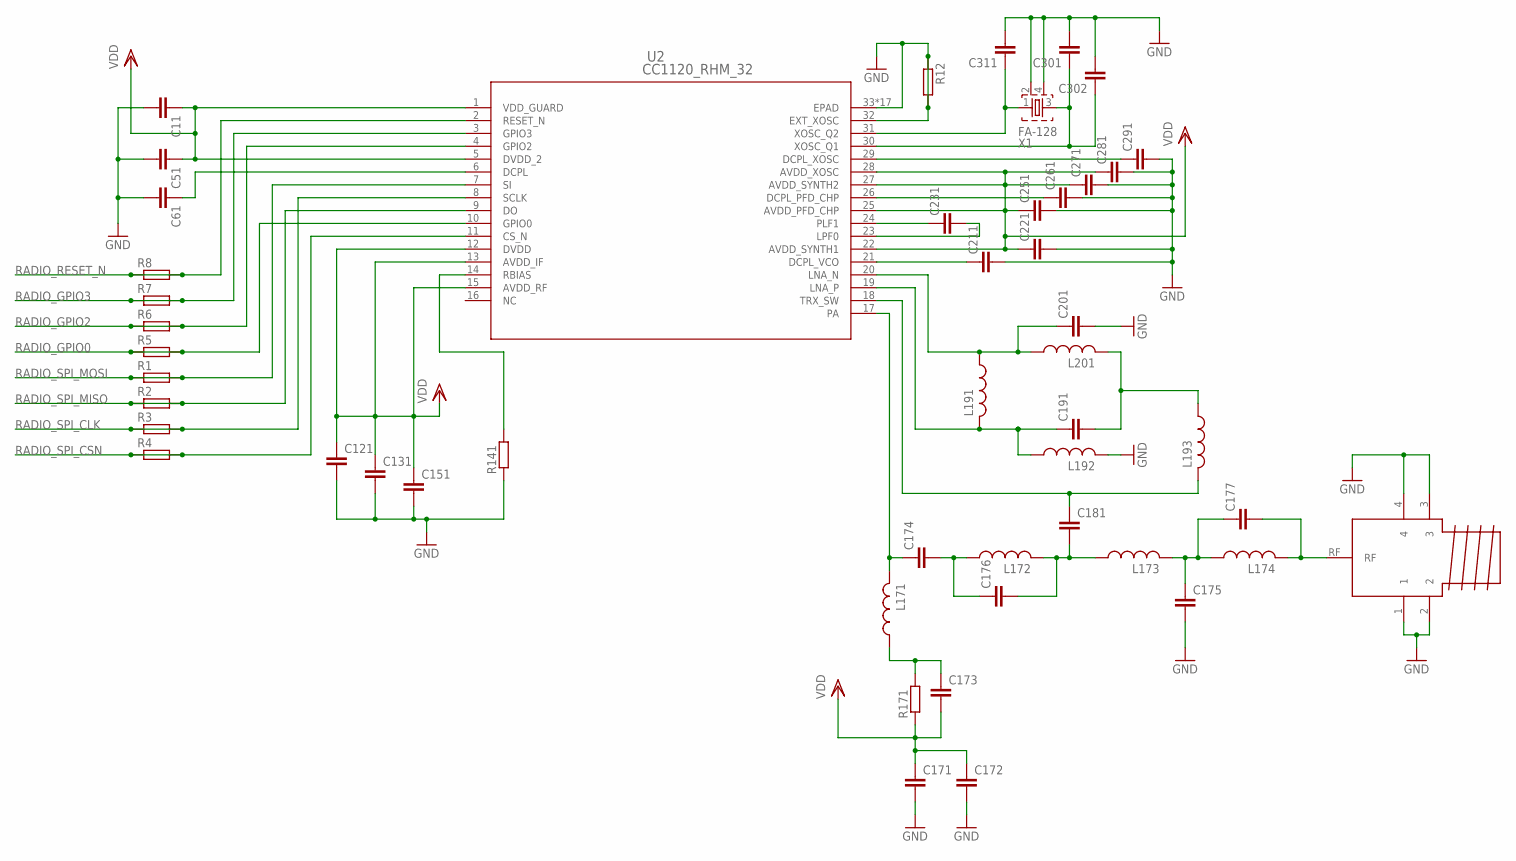
[picture p20: schematic CC1120-chunk.sch]

Parts:
ANT_868: SMA; JOHNSON_142-0701-806
C11, C51, C61, C121, C131, C151, C171, C172, C173, C174, C175, C176, C177, C181, C191, C201, C211, C221, C231, C251, C261, C271, C281, C291, C301, C302, C311: C_EU; C0402_SMALL
L171, L172, L173, L174, L191, L192, L193, L201: L_US; C0402_SMALL
R1, R2, R3, R4, R5, R6, R7, R8: R-EU_R0603; R0603
R12, R141, R171: R_EU; C0402_SMALL
U2: CC1120_RHM_32; RHM32_3P7X3P7
X1: FA-128

Connections:
GND: ANT_868.1, ANT_868.2, ANT_868.3, ANT_868.4, C11.2, C51.2, C61.2, C121.2, C131.2, C151.2, C171.2, C172.2, C175.2, C201.2, C211.2, C221.2, C251.2, C261.2, C271.2, C281.2, C291.2, C301.2, C302.2, C311.2, L192.2, R12.1, R12.2, R141.1, U2.32 (EXT_XOSC), U2.33 (EPAD), U2.V (EPAD), U2.V_2 (EPAD), U2.V_3 (EPAD), U2.V_4 (EPAD), U2.V_5 (EPAD), U2.V_6 (EPAD), U2.V_7 (EPAD), U2.V_8 (EPAD), U2.V_9 (EPAD), U2.V_10 (EPAD), U2.V_11 (EPAD), U2.V_12 (EPAD), U2.V_13 (EPAD), U2.V_14 (EPAD), U2.V_15 (EPAD), U2.V_16 (EPAD), X1.2, X1.4
unnamed: C231.1, U2.24 (PLF1)
unnamed: C231.2, U2.23 (LPF0)
unnamed: C211.1, U2.21 (DCPL_VCO)
unnamed: C61.1, U2.6 (DCPL)
unnamed: C261.1, U2.26 (DCPL_PFD_CHP)
unnamed: C311.1, U2.31 (XOSC_Q2), X1.1
unnamed: C301.1, C302.1, U2.30 (XOSC_Q1), X1.3
unnamed: C291.1, U2.29 (DCPL_XOSC)
unnamed: C201.1, L191.1, L201.1, U2.20 (LNA_N)
unnamed: C191.1, L191.2, L192.1, U2.19 (LNA_P)
unnamed: C191.2, L193.1, L201.2
unnamed: C181.1, L193.2, U2.18 (TRX_SW)
unnamed: R141.2, U2.14 (RBIAS)
unnamed: C174.1, L171.2, U2.17 (PA)
unnamed: C174.2, C176.1, L172.1
unnamed: C176.2, C181.2, L172.2, L173.1
unnamed: C175.1, C177.1, L173.2, L174.1
unnamed: ANT_868.RF, C177.2, L174.2
unnamed: C173.1, L171.1, R171.2
RADIO_GPIO0: R5.1, R5.2, U2.10 (GPIO0)
RADIO_GPIO2: R6.1, R6.2, U2.4 (GPIO2)
RADIO_GPIO3: R7.1, R7.2, U2.3 (GPIO3)
RADIO_RESET_N: R8.1, R8.2, U2.2 (RESET_N)
RADIO_SPI_CLK: R3.1, R3.2, U2.8 (SCLK)
RADIO_SPI_CSN: R4.1, R4.2, U2.11 (CS_N)
RADIO_SPI_MISO: R2.1, R2.2, U2.9 (DO)
RADIO_SPI_MOSI: R1.1, R1.2, U2.7 (SI)
VDD: C11.1, C51.1, C121.1, C131.1, C151.1, C171.1, C172.1, C173.2, C221.1, C251.1, C271.1, C281.1, R171.1, U2.1 (VDD_GUARD), U2.5 (DVDD_2), U2.12 (DVDD), U2.13 (AVDD_IF), U2.15 (AVDD_RF), U2.22 (AVDD_SYNTH1), U2.25 (AVDD_PFD_CHP), U2.27 (AVDD_SYNTH2), U2.28 (AVDD_XOSC)

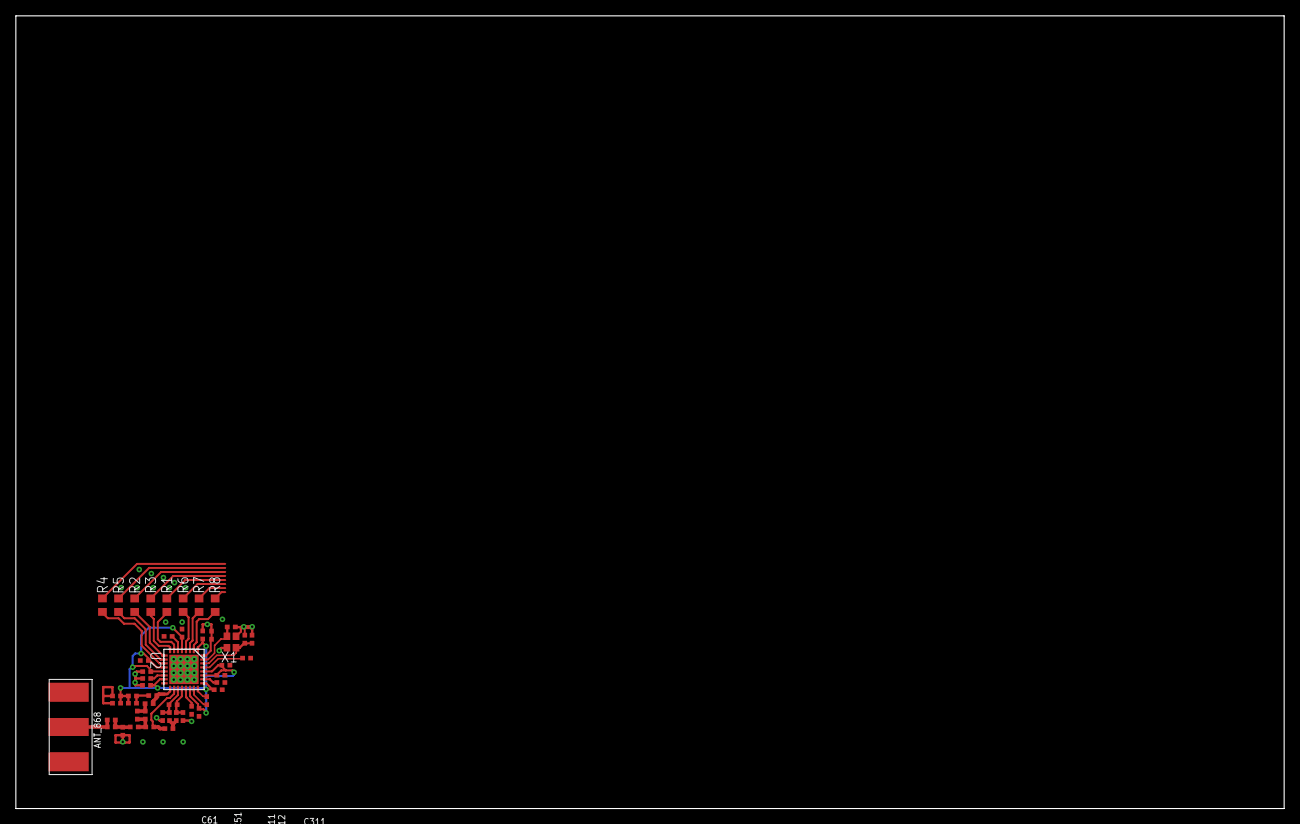
[picture p21: board CC1120-chunk.brd from above]

Board: 2 copper layers, 160.0 x 100.0 mm, 49 parts (0 on the bottom side), 29 nets.
