feshie/ms2/cc1120/cc1120em.brd

## EAGLE design cc1120/cc1120em.brd (2016-03-16)

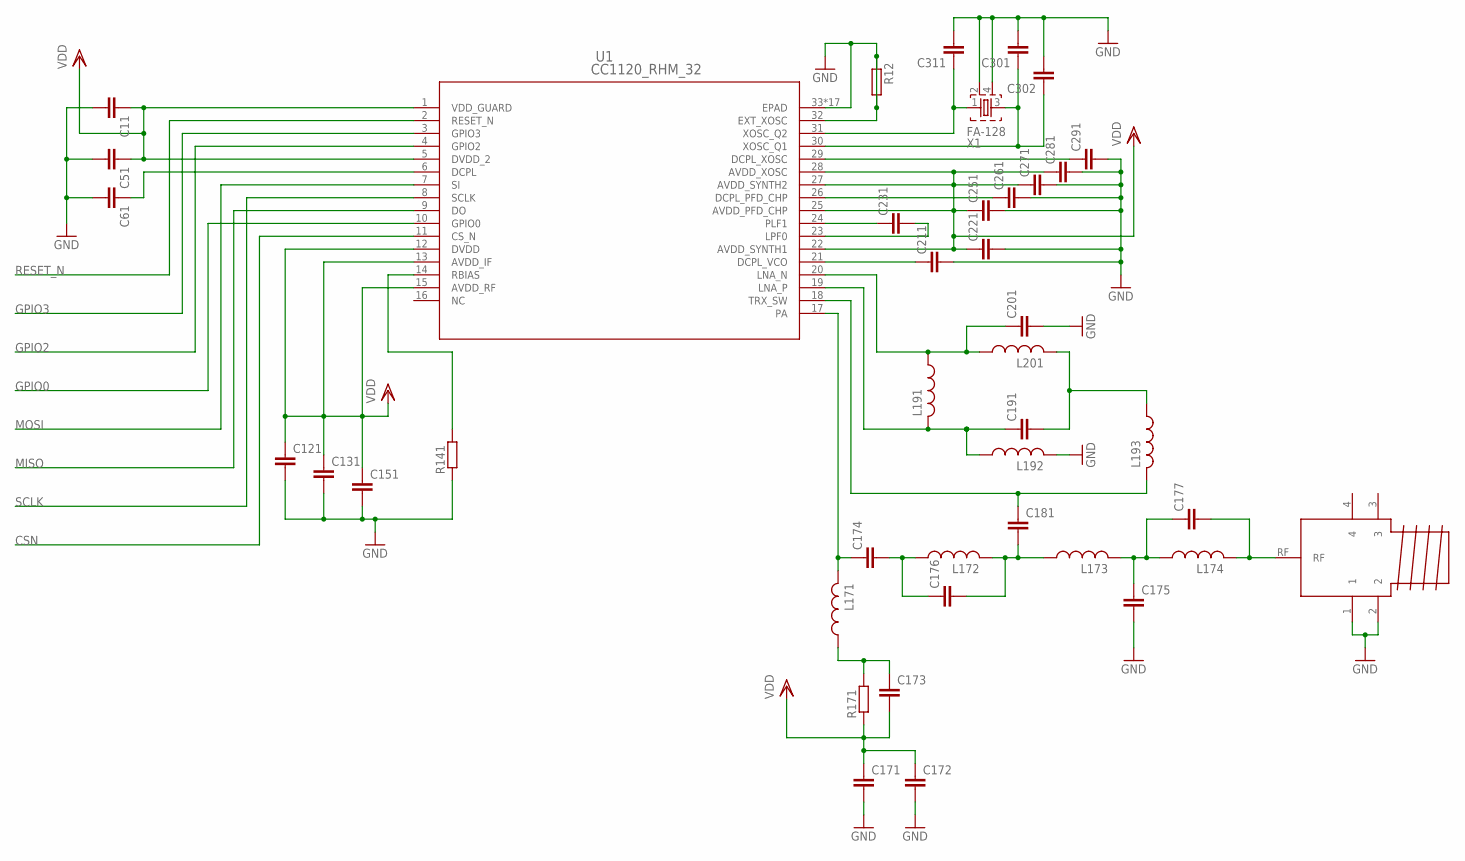
[picture p22: schematic cc1120em.sch]

Parts:
ANT_868: SMA; JOHNSON_142-0701-806
C11, C51, C61, C121, C131, C151, C171, C172, C173, C174, C175, C176, C177, C181, C191, C201, C211, C221, C231, C251, C261, C271, C281, C291, C301, C302, C311: C_EU; C0402_SMALL
L171, L172, L173, L174, L191, L192, L193, L201: L_US; C0402_SMALL
R12, R141, R171: R_EU; C0402_SMALL
U1: CC1120_RHM_32; RHM32_3P7X3P7
X1: FA-128

Connections:
3: ANT_868.3
4: ANT_868.4
CSN: U1.11 (CS_N)
GND: ANT_868.1, ANT_868.2, C11.2, C51.2, C61.2, C121.2, C131.2, C151.2, C171.2, C172.2, C175.2, C201.2, C211.2, C221.2, C251.2, C261.2, C271.2, C281.2, C291.2, C301.2, C302.2, C311.2, L192.2, R12.1, R12.2, R141.1, U1.32 (EXT_XOSC), U1.33 (EPAD), U1.V (EPAD), U1.V_2 (EPAD), U1.V_3 (EPAD), U1.V_4 (EPAD), U1.V_5 (EPAD), U1.V_6 (EPAD), U1.V_7 (EPAD), U1.V_8 (EPAD), U1.V_9 (EPAD), U1.V_10 (EPAD), U1.V_11 (EPAD), U1.V_12 (EPAD), U1.V_13 (EPAD), U1.V_14 (EPAD), U1.V_15 (EPAD), U1.V_16 (EPAD), X1.2, X1.4
GPIO0: U1.10 (GPIO0)
GPIO2: U1.4 (GPIO2)
GPIO3: U1.3 (GPIO3)
MISO: U1.9 (DO)
MOSI: U1.7 (SI)
unnamed: C231.1, U1.24 (PLF1)
unnamed: C231.2, U1.23 (LPF0)
unnamed: C211.1, U1.21 (DCPL_VCO)
unnamed: C61.1, U1.6 (DCPL)
unnamed: C261.1, U1.26 (DCPL_PFD_CHP)
unnamed: C311.1, U1.31 (XOSC_Q2), X1.1
unnamed: C301.1, C302.1, U1.30 (XOSC_Q1), X1.3
unnamed: C291.1, U1.29 (DCPL_XOSC)
unnamed: C201.1, L191.1, L201.1, U1.20 (LNA_N)
unnamed: C191.1, L191.2, L192.1, U1.19 (LNA_P)
unnamed: C191.2, L193.1, L201.2
unnamed: C181.1, L193.2, U1.18 (TRX_SW)
unnamed: R141.2, U1.14 (RBIAS)
unnamed: C174.1, L171.2, U1.17 (PA)
unnamed: C174.2, C176.1, L172.1
unnamed: C176.2, C181.2, L172.2, L173.1
unnamed: C175.1, C177.1, L173.2, L174.1
unnamed: ANT_868.RF, C177.2, L174.2
unnamed: C173.1, L171.1, R171.2
RESET_N: U1.2 (RESET_N)
SCLK: U1.8 (SCLK)
VDD: C11.1, C51.1, C121.1, C131.1, C151.1, C171.1, C172.1, C173.2, C221.1, C251.1, C271.1, C281.1, R171.1, U1.1 (VDD_GUARD), U1.5 (DVDD_2), U1.12 (DVDD), U1.13 (AVDD_IF), U1.15 (AVDD_RF), U1.22 (AVDD_SYNTH1), U1.25 (AVDD_PFD_CHP), U1.27 (AVDD_SYNTH2), U1.28 (AVDD_XOSC)

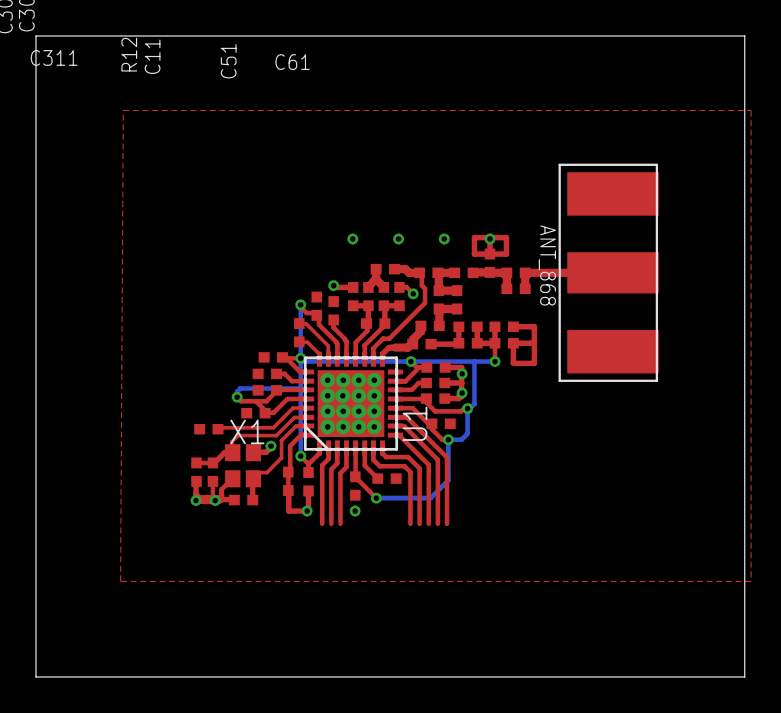
[picture p23: board cc1120em.brd from above]

Board: 2 copper layers, 39.4 x 35.6 mm, 41 parts (0 on the bottom side), 21 nets.
