feshie/ms2/(commit log)

2016-03-12 First commit of designs for MS2.
    Initial changes to MS1 include removal of RS232 driver and addition of 2x more RS485 driver.
    TODO:
    * Rotate CC1120/1200 footprint
    * Find/design Zoul part
    * Design CC2538 PCB
    * Incorporate MS1 fixes
    * Sanity check PSUs
    * Tidy up RS485 setup
    [ms2.brd, ms2.sch]
2016-03-12 CC1120 rotated
    [ms2.brd, ms2.sch]
2016-03-13 CC1120 ref design first commit
    [cc1120em.sch]
2016-03-14 CC1120 schematic work.
    [cc1120em.sch]
2016-03-15 Work on MS2
    [cc1120em.sch, ms2.brd, ms2.sch]
2016-03-15 CC1120EM PCB layout
    [cc1120em.brd]
2016-03-15 More work on CC1120 ref design
    [cc1120em.brd, cc1120em.sch]
2016-03-16 Work on CC2538 Z1 board
    [cc1120em.brd, cc1120em.sch]
2016-03-16 Renamed cc2538 to cc2538-z1
    [cc2538-z1.brd, cc2538-z1.sch]
2016-03-16 Work on CC2538 board
    [cc2538-z1.brd, cc2538-z1.sch]
2016-03-16 CC2538 design work
    [cc2538-z1.brd, cc2538-z1.sch]
2016-03-18 USB input layout done
    [cc2538-z1.brd, cc2538-z1.sch]
2016-03-18 Added Radio power filtering & switch.
    I need to stop committing at 6am...
    [cc2538-z1.brd, cc2538-z1.sch]
2016-03-26 Board check in before placing & routing CPU
    Added CC1120/1200 ref chunk
    Added partslist with Farnell links
    [CC1120-chunk.brd, CC1120-chunk.sch, cc2538-z1.brd, cc2538-z1.sch]
2016-03-27 PCB routing attempt 1
    [cc2538-z1.brd, cc2538-z1.sch]
2016-03-27 48 airwires left.
    Still need to finalise SD sel setup.
    May need to swap to a 4-layer board.
    What am I doing working on PCBs at 8 am?
    [cc2538-z1.brd, cc2538-z1.sch]
2016-03-28 Last commit before going 4-layer for cc2538 board.
    [cc2538-z1.brd]
2016-03-30 Moved to a 4-layer board.
    Updated DRU to meet Euro Circuits Class 6C pool service.
    22 airwires left
    TODO: Check SD card SEL implementation.
    [cc2538-z1.brd, cc2538-z1.sch]
2016-03-30 A lot of work on 4-layer CC2538/1120 design.
    [cc2538-z1.brd, cc2538-z1.sch]
2016-03-31 All traces apart from SDSEL routed. Need to tweak RF layout
    [cc2538-z1.brd]
2016-03-31 Sorted out the RF traces a bit.
    [cc2538-z1.brd]
2016-03-31 Added Serial > 3v3 diode.
    Added I2C pullup
    still need to work out SD SEL
    [cc2538-z1.brd, cc2538-z1.sch]
2016-04-01 Added 2-pin round pinhead
    [cc2538-z1.brd, cc2538-z1.sch]
2016-04-01 plit schematic into separate pages & added framesy
    [cc2538-z1.brd, cc2538-z1.sch]
2016-04-01 Added SPI Flash & moved 2.4G UFL
    [cc2538-z1.brd, cc2538-z1.sch]
2016-04-05 Routing finished? need to sanity check.
    Check pull ups for SPI
    [cc2538-z1.brd, cc2538-z1.sch]
2016-04-06 Added level translator for SPI power down, resized some DNP resistors, some other minor changes.
    [cc2538-z1.brd, cc2538-z1.sch]
2016-04-08 Finalised board design?
    [cc2538-z1.brd, cc2538-z1.sch]
2016-04-08 Renamed PCB to Muntjac
    [Muntjac.brd, Muntjac.sch]
2016-04-09 Added LEDs for Serial TX/RX.
    brd as submitted for manufacture.
    [Muntjac.brd, Muntjac.sch]
2016-04-13 Final Muntjac 1.0 commit for manufacture
    [Muntjac.brd, Muntjac.sch]
2016-04-16 Added values to schematic for CC1120 layout.
    Updated parts list.
    [Muntjac.brd, Muntjac.sch]
2016-06-03 Added LTSpice schematic of Switch mode + LDO combo.
    Work on MS2.
    [ms2.brd, ms2.sch]
2016-06-06 "new" power supply implemented on ms2
    Added Eagle files for CC1120 breakout.
    [CC1200_Breakout.brd, CC1200_Breakout.sch, ms2.brd, ms2.sch, parts.xlsx]
2016-06-08 More MS2 layout work.
    [ms2.brd, ms2.sch]
2016-06-08 More MS2 layout work. 23 remaining airwires.
    [ms2.brd]
2016-06-14 MS2 as submitted for manufacture
    [CC1200_Breakout.GBL, CC1200_Breakout.GBO, CC1200_Breakout.GBP, CC1200_Breakout.GBS, CC1200_Breakout.GTL, CC1200_Breakout.GTO, CC1200_Breakout.GTP, CC1200_Breakout.GTS]
2016-07-04 Added Pick & Place BOM plus table feed layout
    [MS2-BOM-Vals.xlsx]
2016-07-06 Added MS2 SMD Part holder schematic for use with laser cutter
2016-07-07 Muntjac hand/Pick&Place layout + component trays.
    [MS2-BOM-Vals.xlsx]
2016-07-07 Added Muntjac Solderpaste layer
